sfuphantom/vcu-hw/PHANTOM_VCU/VCU_BOM_IncludingInventory.xlsx

Comment | Description | Designator | Footprint | Manufacturer Part Number | Quantity | Supplier Part Number 1 | Supplier Subtotal 1 | Inventory in Capstone | Needed (for 10 VCUs), no extras
100nF | CAP MLCC 0.1uF 10V X5R 0402 20% SMD 0402 85C Paper T/R, CAP MLCC 0.1uF 10V X5R 0402 20% SMD 0402 85C Paper T/R, CAP MLCC 0.1uF 10V X5R 0402 20% SMD 0402 85C Paper T/R, CAP MLCC 0.1uF 10V X5R 0402 20% SMD 0402 85C Paper T/R, CAP MLCC 0.1uF 10V X5R 0402 20% SMD 0402 85C Paper T/R, CAP MLCC 0.1uF 10V X5R 0402 20% SMD 0402 85C Paper T/R, CAP MLCC 0.1uF 10V X5R 0402 20% SMD 0402 85C Paper T/R, CAP MLCC 0.1uF 10V X5R 0402 20% SMD 0402 85C Paper T/R, CAP MLCC 0.1uF 10V X5R 0402 20% SMD 0402 85C Paper T/R, CAP MLCC 0.1uF 10V X5R 0402 20% SMD 0402 85C Paper T/R, CAP MLCC 0.1uF 10V X5R 0402 20% SMD 0402 85C Paper T/R, CAP MLCC 0.1uF 10V X5R 0402 20% SMD 0402 85C Paper T/R, CAP MLCC 0.1uF 10V X5R 0402 20% SMD 0402 85C Paper T/R, CAP MLCC 0.1uF 10V X5R 0402 20% SMD 0402 85C Paper T/R, CAP MLCC 0.1uF 10V X5R 0402 20% SMD 0402 85C Paper T/R, CAP MLCC 0.1uF 10V X5R 0402 20% SMD 0402 85C Paper T/R, CAP MLCC 0.1uF 10V X5R 0402 20% SMD 0402 85C Paper T/R, CAP MLCC 0.1uF 10V X5R 0402 20% SMD 0402 85C Paper T/R, CAP MLCC 0.1uF 10V X5R 0402 20% SMD 0402 85C Paper T/R, CAP MLCC 0.1uF 10V X5R 0402 20% SMD 0402 85C Paper T/R, CAP MLCC 0.1uF 10V X5R 0402 20% SMD 0402 85C Paper T/R, CAP MLCC 0.1uF 10V X5R 0402 20% SMD 0402 85C Paper T/R, CAP MLCC 0.1uF 10V X5R 0402 20% SMD 0402 85C Paper T/R, CAP MLCC 0.1uF 10V X5R 0402 20% SMD 0402 85C Paper T/R, CAP MLCC 0.1uF 10V X5R 0402 20% SMD 0402 85C Paper T/R, CAP MLCC 0.1uF 10V X5R 0402 20% SMD 0402 85C Paper T/R, CAP MLCC 0.1uF 10V X5R 0402 20% SMD 0402 8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 | C1, C4, C5, C6, C7, C8, C9, C10, C11, C12, C13, C14, C15, C16, C19, C20, C21, C22, C23, C24, C25, C26, C27, C28, C29, C30, C31, C32, C33, C34, C35, C36, C37, C38, C41, C42, C45, C53 | C0402 | CL05A104MP5NNNC, CL05A104MP5NNNC, CL05A104MP5NNNC, CL05A104MP5NNNC, CL05A104MP5NNNC, CL05A104MP5NNNC, CL05A104MP5NNNC, CL05A104MP5NNNC, CL05A104MP5NNNC, CL05A104MP5NNNC, CL05A104MP5NNNC, CL05A104MP5NNNC, CL05A104MP5NNNC, CL05A104MP5NNNC, CL05A104MP5NNNC, CL05A104MP5NNNC, CL05A104MP5NNNC, CL05A104MP5NNNC, CL05A104MP5NNNC, CL05A104MP5NNNC, CL05A104MP5NNNC, CL05A104MP5NNNC, CL05A104MP5NNNC, CL05A104MP5NNNC, CL05A104MP5NNNC, CL05A104MP5NNNC, CL05A104MP5NNNC, CL05A104MP5NNNC, CL05A104MP5NNNC, CL05A104MP5NNNC, CL05A104MP5NNNC, CL05A104MP5NNNC, CL05A104MP5NNNC, CL05A104MP5NNNC, CL05A104MP5NNNC, CL05A104MP5NNNC, CC0402ZRY5V8BB104, CC0402ZRY5V8BB104 | 38 | 1276-1443-1-ND |  | 185 | 295
100nF 25V | CAP MLCC 0.1uF 25V | C53, C45 |  |  | 2 | 311-1375-1-ND |  | 17 | 3
1uF | CAP MLCC 1uF 10V 0402 X5R 20% SMD 0402 85C Paper T/R | C2, C3, C17, C18, C48, C56 | C0402 | CL05A105MP5NNNC | 6 | 1276-1448-1-ND (https://octopart-clicks.com/click/altium?sku=1276-1448-1-ND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) | 0.6 | 90 | 0
33pF | CAP MLCC 33pF 10V C0G, NP0 0402 (1005 Metric) 0.039" L x 0.020" W (1.00mm x 0.50mm) | C39, C40 | C0402 | 885012005010 | 2 | 732-7428-1-ND (https://octopart-clicks.com/click/altium?sku=732-7428-1-ND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) | 0.2 | 13 | 7
10uF | CAP MLCC 10uF 25V X5R 0805 | C43, C44, C51, C52 | R0805-3D | TMK212BBJ106KG-T | 4 | 587-2985-1-ND (https://octopart-clicks.com/click/altium?sku=587-2985-1-ND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) | 1 | 19 | 21
22uF | CAP MLCC 22uF 10V 0805 X5R 20% SMD 0805 85C Embossed T/R | C46, C47, C54, C55 | R0805-3D | GRM21BR61A226ME51L | 4 | 490-10511-1-ND (https://octopart-clicks.com/click/altium?sku=490-10511-1-ND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) | 1.4 | 21 | 19
10nF | CAP MLCC 10nF 10V 0402 5R 10% SMD 0402 85C T/R | C49, C57 | C0402 | GRM155R61A103KA01D | 2 | 490-6296-1-ND (https://octopart-clicks.com/click/altium?sku=490-6296-1-ND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) | 0.2 | 13 | 7
10pF | CAP MLCC 10pF 10V 0402 C0G, NP0 0402 (1005 Metric) 0.039" L x 0.020" W (1.00mm x 0.50mm) | C50, C58 | C0402 | 885012005007 | 2 | 732-7425-1-ND (https://octopart-clicks.com/click/altium?sku=732-7425-1-ND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) | 0.2 | 13 | 7
10uF | CAP CER 10uF 16V X5R 10% SMD 0805 85C T/R | C60, C61 | C0805 | CL21A106KOQNNNE | 2 | 1276-1096-1-ND (https://octopart-clicks.com/click/altium?sku=1276-1096-1-ND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) | 0.34 | 0 | 20
Green | LED GREEN CLEAR 0603 SMD LED, 0603, B GREEN, 40MCD, 570NM | D1, D2, D3, D18, D19 | LED_0603 | 150060VS75000 | 5 | 732-4980-1-ND (https://octopart-clicks.com/click/altium?sku=732-4980-1-ND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) | 0.7 | 22 | 28
Red | LED RED CLEAR 0603 SMD 625 nm, 2 V, 30 mA, 250 mcd | D4 | LED_0603 | 150060RS75000 | 1 | 732-4978-1-ND (https://octopart-clicks.com/click/altium?sku=732-4978-1-ND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) | 0.14 | 4 | 6
Blue | LED BLUE CLEAR 0603 SMD 3.2V 145MCD, 470NM | D5, D7, D9, D11, D12, D16 | LED_0603 | 150060BS75000 | 6 | 732-4966-1-ND (https://octopart-clicks.com/click/altium?sku=732-4966-1-ND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) | 0.9 | 19 | 31
S3BB-TP | DIODE GEN PURP 100V 3A DO214AA | D6, D8, D10 | DO-214AA_Diode | S3BB-TP | 3 | S3BB-TPMSCT-ND (https://octopart-clicks.com/click/altium?sku=S3BB-TPMSCT-ND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) | 1.62 | 17 | 13
EAST1616RGBB4 | LED TRICOLOR RED GREEN BLUE | D14 | LED_TRICOLOR | EAST1616RGBB4 | 1 | '1080-1552-1-ND |  | 0 | 10
3.3V | DIODE ZENER 3.3V 1.5W SMA | D15 | DIODE_TVS | 1SMA5913BT3G | 1 | SMAJ5.0ALFCT-ND (https://octopart-clicks.com/click/altium?sku=SMAJ5.0ALFCT-ND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) | 0.47 | 4 | 6
6.4V | DIODE TVS_6V4 5VWM 9.2VC SMA | D17 | DIODE_TVS | SMAJ5.0A | 1 | 1SMA5913BT3GOSCT-ND (https://octopart-clicks.com/click/altium?manufacturer=ON%20Semiconductor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) | 0.51 | 5 | 5
23R @ 100 MHz | FERRITE BEAD Ind Chip Bead Multi-Layer 23Ohm 30% 100MHz Ferrite 3.5A 1806 T/R | FB1, FB2 | FB_1806 | FBMJ4516HL230NTV | 2 | 587-3857-1-ND (https://octopart-clicks.com/click/altium?sku=587-3857-1-ND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) | 0.52 | 8 | 12
61300511121 | CONN_HeaderPins5pos WURTH ELEKTRONIK 61300511121 Board-To-Board Connector, Vertical, WR-PHD Series, Through Hole, Header, 5 Contacts, 2.54 mm | J1 | 5PIN_HEADER | 61300511121 | 1 | 732-5318-ND (https://octopart-clicks.com/click/altium?sku=732-5318-ND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) | 0.25 | 0 | 10
61300411121 | CONN_HeaderPins4pos WURTH ELEKTRONIK 61300411121 Board-To-Board Connector, Vertical, WR-PHD Series, Through Hole, Header, 4 Contacts, 2.54 mm | J2 | 4PIN_HEADER | 61300411121 | 1 | 732-5317-ND (https://octopart-clicks.com/click/altium?sku=732-5317-ND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) | 0.18 | 0 | 10
952-2262-ND | CONN_HeaderPins2pos Headers & Wire Housings 02 SIL VERTICAL PIN HEADER TIN | JP1, JP2, JP4 | 2PIN_HEADER | M20-9990246 | 3 | 952-2262-ND (https://octopart-clicks.com/click/altium?sku=952-2262-ND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) | 0.33 | 0 | 30
732-5316-ND | CONN_HeaderPins3pos WURTH ELEKTRONIK Board-To-Board Connector, Vertical, WR-PHD Series, Through Hole, Header, 3 Contacts, 2.54 mm | JP3, JP5, JP6 | 3PIN_HEADER | 61300311121 | 3 | 732-5316-ND (https://octopart-clicks.com/click/altium?sku=732-5316-ND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) | 0.39 | 0 | 30
2.2uH | IND 2.2uH 6.3A 19.2mOhm 30% 100KHz Ferrite T/R | L1 | IND-6mm | 1255AY-2R2N=P3 | 1 | 490-10807-1-ND (https://octopart-clicks.com/click/altium?sku=490-10807-1-ND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) | 0.48 | 5 | 5
3.3uH | IND 3.3µH 6.5A 25.2 mOhm Max Nonstandard | L2 | IND-6mm | 1264EY-3R3N=P3 | 1 | 490-10821-1-ND (https://octopart-clicks.com/click/altium?sku=490-10821-1-ND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) | 0.51 | 5 | 5
PSMN022-30BL,118 | MOSFET N-CH 30V 30A 22.6mOhm Rds(ON) | Q1 | D2PAK_FETs | PSMN022-30BL,118 | 1 | 1727-7117-1-ND (https://octopart-clicks.com/click/altium?manufacturer=NXP%20Semiconductors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) | 0.84 | 0 | 10
NCV8406ASTT1G | MOSFET Self-Protected Low Side Driver Automotive 4-Pin(3+Tab) SOT-223 T/R | Q4, Q5, Q6 | SOT-223_NFET | NCV8406ASTT1G | 3 | NCV8406ASTT1GOSDKR-ND (https://octopart-clicks.com/click/altium?manufacturer=ON%20Semiconductor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) | 4.08 | 12 | 18
2k2 | RES SMD 2.2K OHM 5% 1/16W 0402 | R1, R6, R7, R15, R16, R17, R23, R24, R25, R26, R37, R38 | R0402 | RC0402JR-072K2L | 12 | 311-2.2KJRCT-ND (https://octopart-clicks.com/click/altium?sku=311-2.2KJRCT-ND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) | 0.156 | 85 | 35
665R | RES SMD 665 OHM 1% 0402 1/16W | R2 | R0402 | RC0402FR-07665RL | 1 | YAG3208CT-ND (https://octopart-clicks.com/click/altium?sku=YAG3208CT-ND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) | 0.1 | 9 | 1
280R | RES SMD 280 OHM 1% 1/16W 0402 | R3, R45, R46 | R0402 | RC0402FR-07280RL | 3 | 311-280LRCT-ND (https://octopart-clicks.com/click/altium?sku=311-280LRCT-ND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) | 0.3 | 9 | 21
10k | RES SMD 10K OHM 5% 1/16W 0402 | R4, R8, R9, R18, R21, R27, R28, R29, R31, R34, R44, R51 | R0402 | RC0402JR-0710KL | 12 | 311-10KJRCT-ND (https://octopart-clicks.com/click/altium?sku=311-10KJRCT-ND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) | 0.156 | 90 | 30
0R001 | Res Thick Film 2512 0.001 Ohm 1% 1W 250ppm/C to 450ppm/C Molded SMD Embossed Carrier T/R | R5 | R2512 | ERJ-M1WTF1M0U | 1 | P1.0NDCT-ND (https://octopart-clicks.com/click/altium?sku=P1.0NDCT-ND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) | 0.57 | 5 | 5
0R | RES SMD 0 OHM 1/16W 0402 | R10, R11, R14, R20, R42, R47, R48 | R0402 | RC0402JR-070RL | 7 | 311-0.0JRCT-ND (https://octopart-clicks.com/click/altium?sku=311-0.0JRCT-ND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) | 0.7 | 36 | 34
120R | RES SMD 120 OHM 5% 0402 1/16W ±100ppm/C Molded SMD Paper T/R | R12 | R0402 | RMCF0402JT120R | 1 | RMCF0402JT120RCT-ND (https://octopart-clicks.com/click/altium?manufacturer=Stackpole%20Electronics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) | 0.1 | 9 | 1
R60 | RES SMD 60.4 OHM 1% 0402 1/16W 100ppm/C Molded SMD SMD Paper T/R | R13 | R0402 | RMCF0402FT60R4 | 1 | RMCF0402FT60R4CT-ND (https://octopart-clicks.com/click/altium?manufacturer=Stackpole%20Electronics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) | 0.1 | 9 | 1
10R | RES SMD 10 OHM 5% 1/16W 0402 | R19, R39, R43 | R0402 | RC0402JR-0710RL | 3 | 311-10JRCT-ND (https://octopart-clicks.com/click/altium?sku=311-10JRCT-ND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) | 0.3 | 17 | 13
1k | RES SMD 1K OHM 0.5% 1/16W 0402 | R22, R49 | R0402 | RR0510P-102-D | 2 | RR05P1.0KDCT-ND (https://octopart-clicks.com/click/altium?sku=RR05P1.0KDCT-ND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) | 0.2 | 0 | 20
60R4 | RES SMD 60.4 OHM 1% 0402 1/16W 100ppm/C Molded SMD SMD Paper T/R | R30, R40, R41 | R0402 | RMCF0402FT60R4 | 3 | RMCF0402FT60R4CT-ND (https://octopart-clicks.com/click/altium?manufacturer=Stackpole%20Electronics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) | 0.3 | 7 | 23
73.2k | RES SMD 73.2K Ohm 0402 1% 0.063W(1/16W) ±100ppm/C Molded SMD Automotive T/R | R32 | R0402 | RMCF0402FT73K2 | 1 | RMCF0402FT73K2CT-ND (https://octopart-clicks.com/click/altium?manufacturer=Stackpole%20Electronics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) | 0.1 | 9 | 1
22.1k | RES SMD 22.1K 0402 Ohm 1% 1/16W ±100ppm/C Molded SMD SMD Paper T/R | R33, R36 | R0402 | RMCF0402FT22K1 | 2 | RMCF0402FT22K1CT-ND (https://octopart-clicks.com/click/altium?manufacturer=Stackpole%20Electronics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) | 0.2 | 13 | 7
124k | RES SMD 124K 0402 1% 1/16W 100ppm/C Molded SMD Paper T/R | R35 | R0402 | RMCF0402FT124K | 1 | RMCF0402FT124KCT-ND (https://octopart-clicks.com/click/altium?manufacturer=Stackpole%20Electronics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) | 0.1 | 9 | 1
2k | RES SMD 2K OHM 1% 1/16W 0402 | R50 | R0402 | RC0402FR-072KL | 1 | 311-2KLRCT-ND (https://octopart-clicks.com/click/altium?sku=311-2KLRCT-ND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) | 0.1 | 0 | 10
33R | RES SMD 33 OHM 5% 0.4W 0805 | R52 | R0805-3D | ESR10EZPJ330 | 1 | RHM33KCT-ND (https://octopart-clicks.com/click/altium?sku=RHM33KCT-ND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) | 0.1 | 0 | 10
PTS645SM43SMTR92LFS | SWITCH TACTILE SPST-NO 0.05A 12V | S1, S2 | PUSH_BUTTON | PTS645SM43SMTR92LFS | 2 | CKN9112CT-ND (https://octopart-clicks.com/click/altium?sku=CKN9112CT-ND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) | 0.32 | 8 | 12
5015 | TEST POINT, PCB, SMT | TP1, TP2, TP3, TP4, TP5, TP6, TP14, TP15 | TP_HOOK | 5015 | 8 | 36-5015CT-ND (https://octopart-clicks.com/click/altium?sku=36-5015CT-ND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) | 3.76 | 30 | 50
INA226AIDGSR | IC MONITOR PWR/CURR BIDIR 10MSOP | U1 | 10-VSSOP_INA226 | INA226AIDGSR | 1 | 296-29034-1-ND (https://octopart-clicks.com/click/altium?sku=296-29034-1-ND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) | 2.88 | 4 | 6
AP65550FN-7 | IC BUCK SYNC 5A, 18V VIN MAX 650kHz COT Step-Down Conv | U2, U3 | DFN-10 | AP65550FN-7 | 2 | AP65550FN-7DICT-ND (https://octopart-clicks.com/click/altium?sku=AP65550FN-7DICT-ND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) | 1.54 | 13 | 7
MIC5504-1.2YM5-TR | IC LDO 1.2V 300mA Enable Pull-Down & Auto Discharge, 5 SOT-23 T/R | U4 | SOT23-5-MIC5504 | MIC5504-1.2YM5-TR | 1 | 576-4878-1-ND (https://octopart-clicks.com/click/altium?sku=576-4878-1-ND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) | 0.11 | 14 | 0
TMS5701227CPGEQQ1 | IC MCU 16-Bit/32-Bit Hercules TMS570 ARM Cortex R4F RISC 1280KB Flash 1.2V/3.3V 144-Pin LQFP | U5 | LQFP-144 | TMS5701227CPGEQQ1 | 1 | 296-42451-ND (https://octopart-clicks.com/click/altium?sku=296-42451-ND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) | 24.99 | 11 | 0
TPS2115ADRBR | IC OR CTRLR SRC SELECT 8SON | U6 | VSON-8 | TPS2115ADRBR | 1 | 296-23394-1-ND (https://octopart-clicks.com/click/altium?sku=296-23394-1-ND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) | 2.01 | 5 | 5
MCP2561FD-E/SN | IC CAN Bus, Transceiver, CAN, 1, 1, 4.5 V, 5.5 V, SOIC | U7 | 8-SOIC_MCP2561 | MCP2561FD-E/SN | 1 | MCP2561FD-E/SN-ND |  | 5 | 5
MCP48FVB01-E/UN | IC DAC 8BIT V-OUT BUFF 10-MSOP | U8 | MSSOP-10 | MCP48FVB01-E/UN | 1 | MCP48FVB01-E/UN-ND (https://octopart-clicks.com/click/altium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) | 0.7 | 0 | 10
FT230XQ-R | IC USB SERIAL BASIC UART 16QFN | U9 | QFN16-EP | FT230XQ-R | 1 | 768-1130-1-ND (https://octopart-clicks.com/click/altium?sku=768-1130-1-ND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) | 2.04 | 4 | 6
STWD100YNYWY3F | IC WATCHDOG TIME CIRCUIT SOT23-5 | U10 | SOT23-5-WATCHDOG | STWD100YNYWY3F | 1 | 497-14411-1-ND (https://octopart-clicks.com/click/altium?sku=497-14411-1-ND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) | 0.94 | 0 | 10
WM10445-ND | CONN_20Positions Molex Stac64 Header, Shrouded Connector 0.100" (2.54mm) Through Hole, Right Angle Tin | X1, X2 | MOLEX_20pin | 0346916200 | 2 | WM10445-ND (https://octopart-clicks.com/click/altium?sku=WM10445-ND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) | 6.44 | 0 | 0
68602-116HLF | CONN_HeaderPins16pos1 6 Positions Header, Unshrouded Connector 0.100" (2.54mm) Through Hole Gold or Gold, GXT™ | X4 | 16PIN_HEADER | 68602-116HLF | 1 | 609-3364-ND (https://octopart-clicks.com/click/altium?manufacturer=AMPHENOL%20ICC%20%28FCI%29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) | 0.79 | 8 | 2
0768250002 | CONN_2Position_MEGAFIT Molex Through Hole, Right Angle Tin | X5 | MOLEX_2PIN_MEGAFIT | 0768250002 | 1 | WM11969-ND (https://octopart-clicks.com/click/altium?sku=WM11969-ND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) | 1.13 | 6 | 4
FTSH-105-01-F-DV-K | CONN_JTAG_10pin .050 Connector Dual Header 10 Position Surface Mount | X6 | JTAG_50mil_10pin | FTSH-105-01-F-DV-K | 1 | SAM8796-ND (https://octopart-clicks.com/click/altium?sku=SAM8796-ND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) | 2.9 | 4 | 6
10118192-0001LF | CONN_USB - micro B USB 2.0 Receptacle Connector 5 Position Surface Mount, Right Angle, Horizontal | X7 | USB_MICRO | 10118192-0001LF | 1 | 609-4613-1-ND (https://octopart-clicks.com/click/altium?manufacturer=AMPHENOL%20ICC%20%28FCI%29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) | 0.42 | 6 | 4
ABLS2-16.000MHZ-D4Y-T | XTAL 16MHz ±30ppm Crystal 18pF 40 Ohm -40°C ~ 85°C Surface Mount HC49/US | XTAL1 | XTAL | ABLS2-16.000MHZ-D4Y-T | 1 | 535-9875-1-ND (https://octopart-clicks.com/click/altium?sku=535-9875-1-ND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) | 0.46 | 6 | 4
12V | DIODE ZENER 12V 5W DO214AA | Z1, Z2, Z3 | DO-214AA_Diode | SMBJ5349B-TP | 3 | SMBJ5349B-TPMSDKR-ND (https://octopart-clicks.com/click/altium?sku=SMBJ5349B-TPMSDKR-ND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) | 2.04 | 12 | 18
mating connectors
mating crimps
