sfuphantom/vcu-hw/PHANTOM_VCU/PHANTOM_VCU_SCHEMATIC.pdf

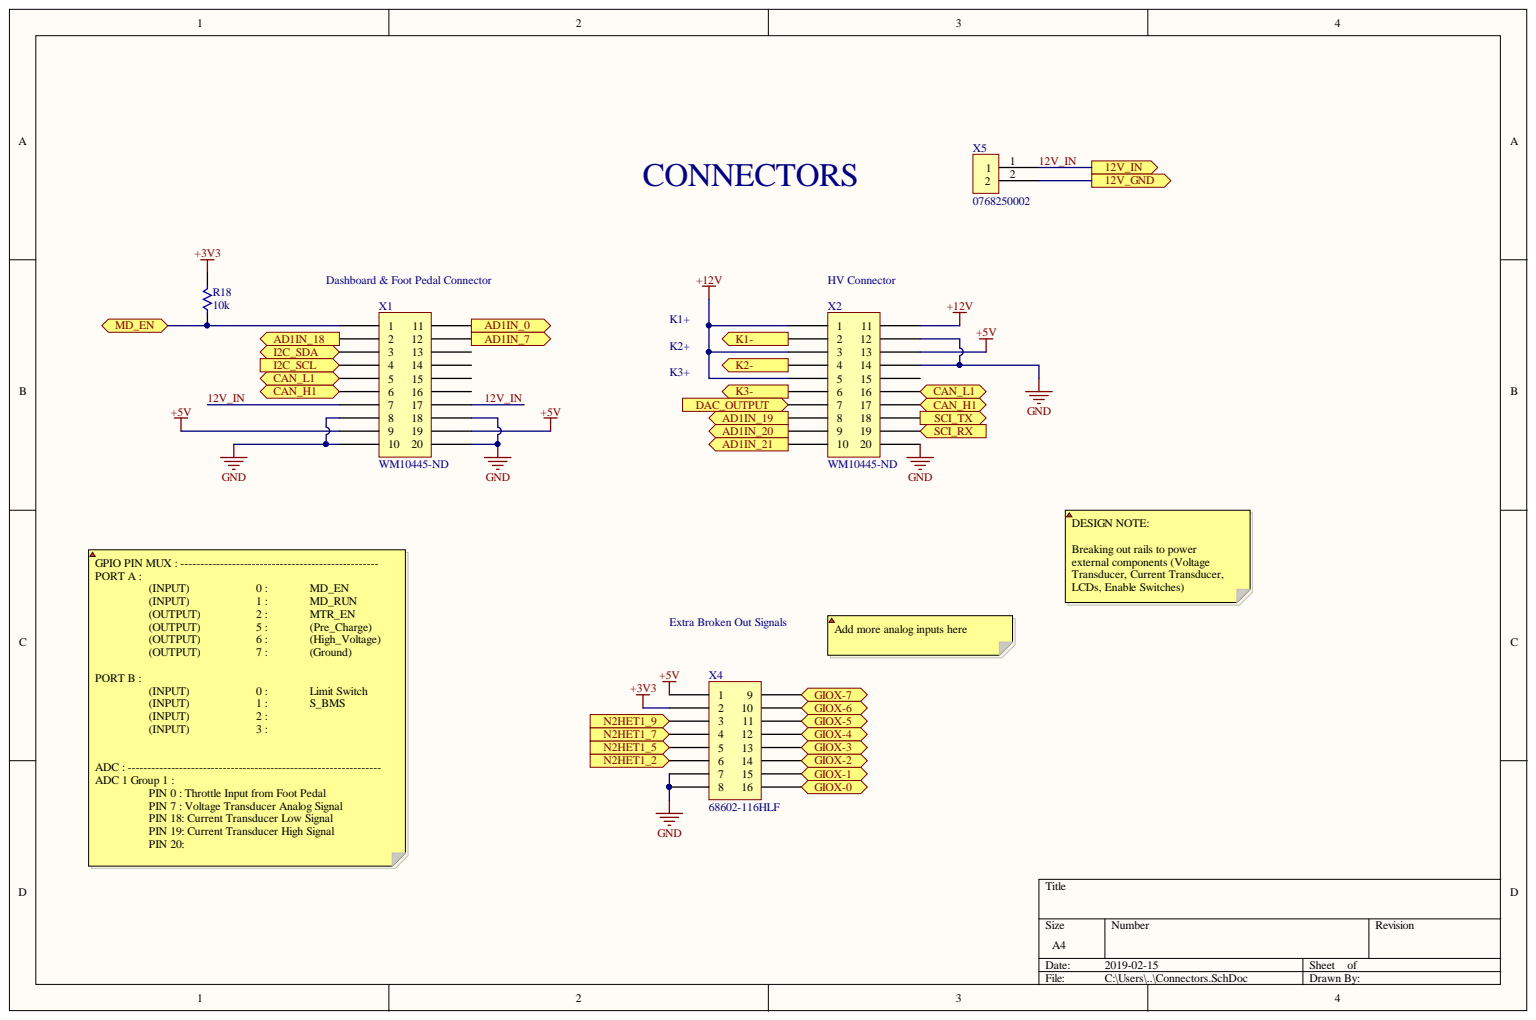
[picture p1: page 1]

Dashboard & Foot Pedal Connector

Breaking out rails to power
external components (Voltage
Transducer, Current Transducer,
LCDs, Enable Switches)

Extra Broken Out Signals

Add more analog inputs here

PIN 0 : Throttle Input from Foot Pedal
PIN 7 : Voltage Transducer Analog Signal
PIN 18: Current Transducer Low Signal
PIN 19: Current Transducer High Signal
PIN 20:

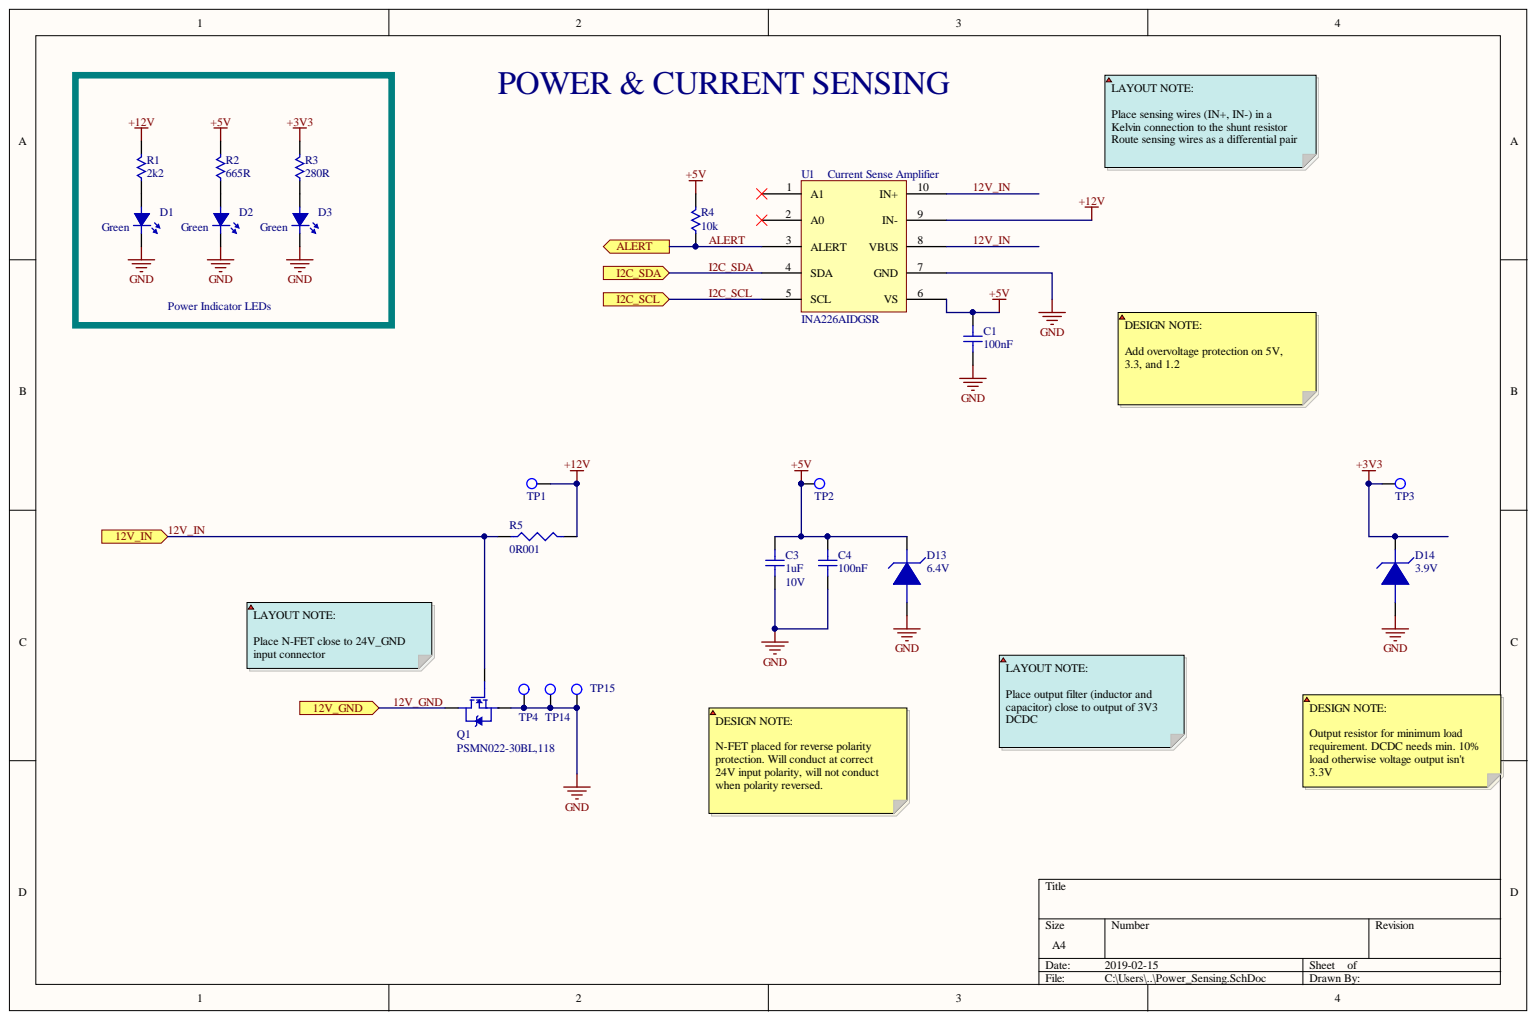
[picture p2: page 2]

Place sensing wires (IN+, IN-) in a
Kelvin connection to the shunt resistor
Route sensing wires as a differential pair

Add overvoltage protection on 5V,
3.3, and 1.2

Place N-FET close to 24V_GND
input connector

Place output filter (inductor and
capacitor) close to output of 3V3

Output resistor for minimum load
requirement. DCDC needs min. 10%
load otherwise voltage output isn't

N-FET placed for reverse polarity
protection. Will conduct at correct
24V input polarity, will not conduct
when polarity reversed.

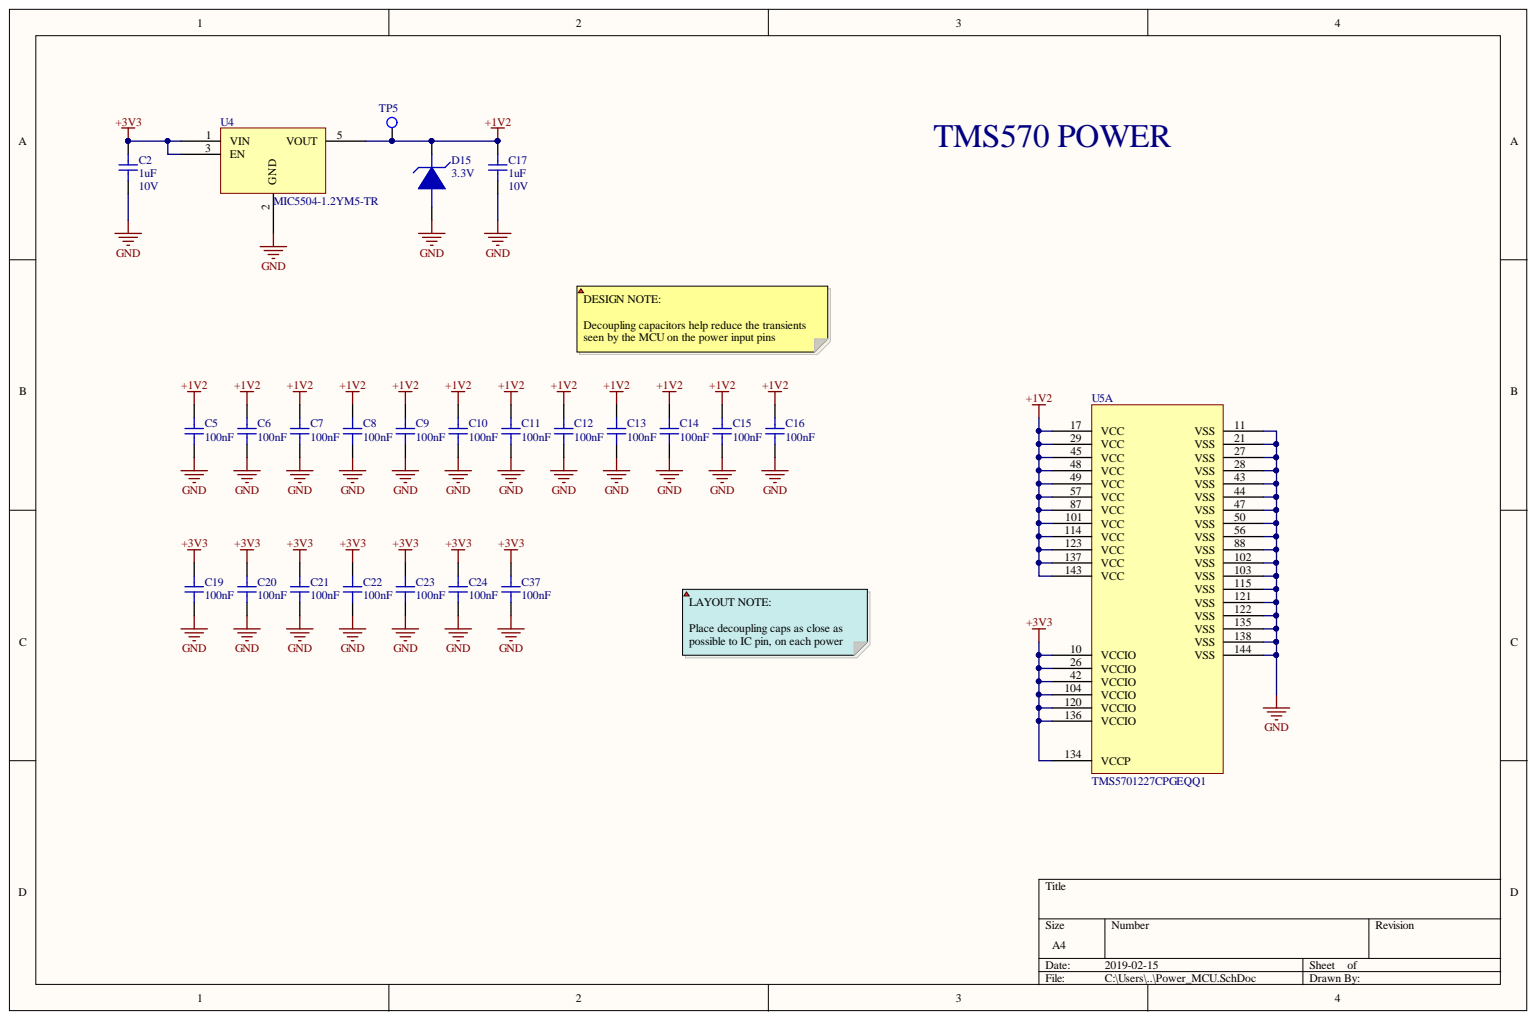
[picture p3: page 3]

Decoupling capacitors help reduce the transients
seen by the MCU on the power input pins

Place decoupling caps as close as
possible to IC pin, on each power

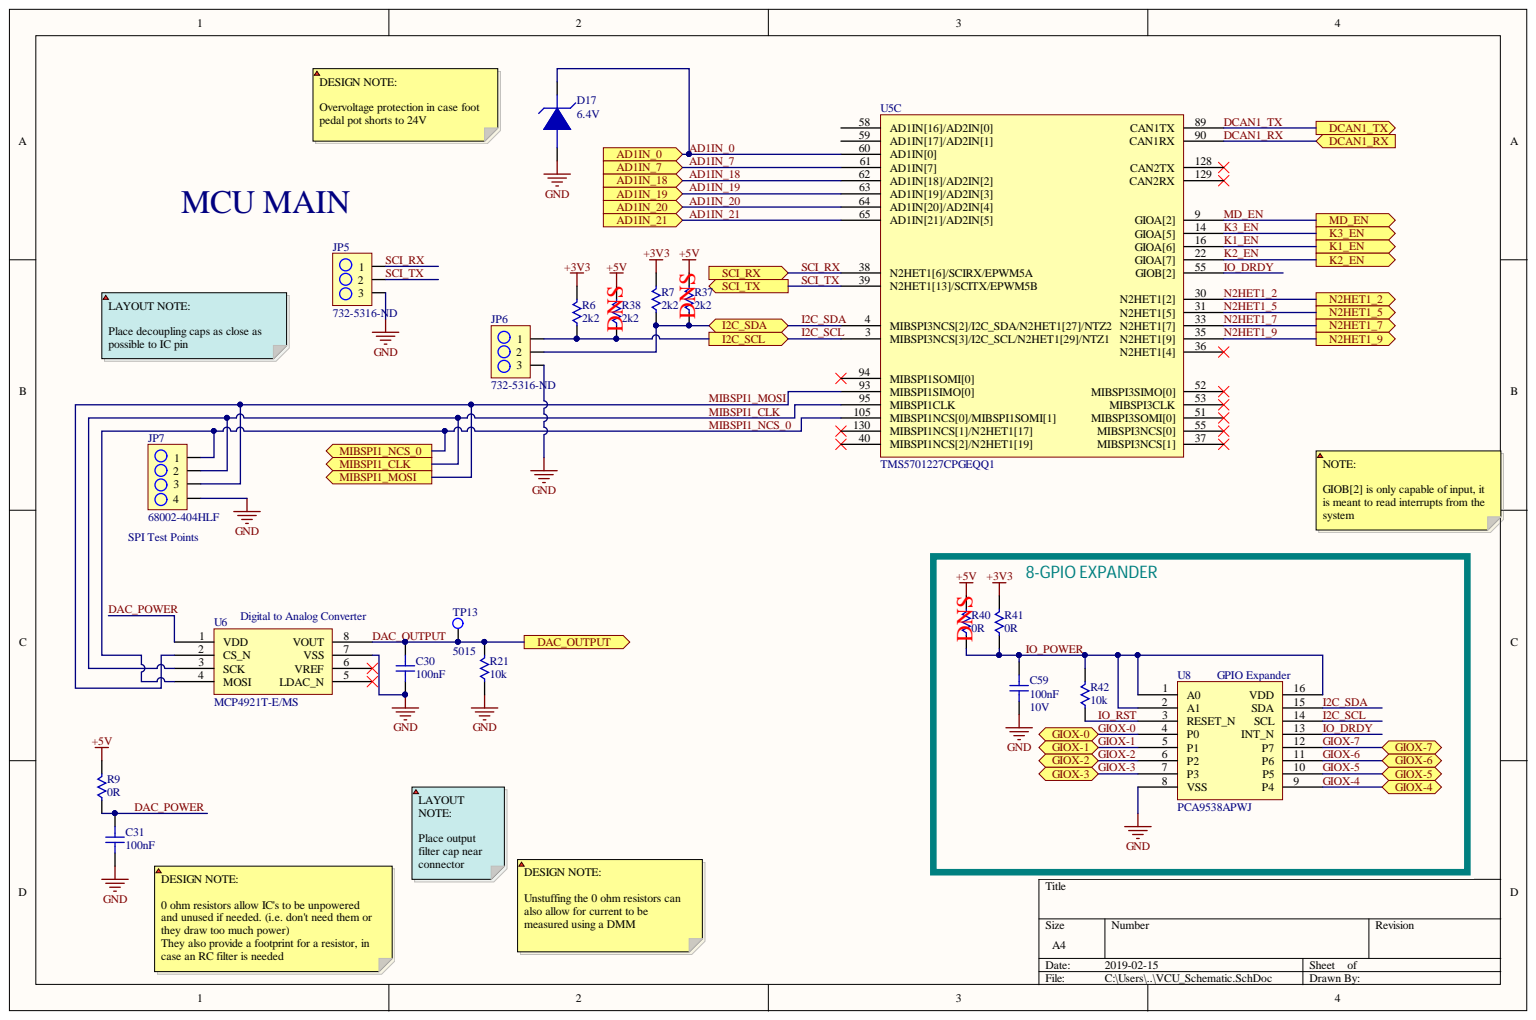
[picture p4: page 4]

Overvoltage protection in case foot
pedal pot shorts to 24V

Place decoupling caps as close as
possible to IC pin

MIBSPI1_CLK | MIBSPI1NCS[0]/MIBSPI1SOMI[1] 105
MIBSPI1_NCS_0 | MIBSPI1NCS[1]/N2HET1[17] 130

JP7 DAC_POWER | | | MIBSPI1NCS[2]/N2HET1[19] 40

GIOB[2] is only capable of input, it
is meant to read interrupts from the
system

+5V +3V3 | R40 0R | 8-GPIO EXPANDER R41 0R

Unstuffing the 0 ohm resistors can
also allow for current to be
measured using a DMM

0 ohm resistors allow IC's to be unpowered
and unused if needed. (i.e. don't need them or
they draw too much power)
They also provide a footprint for a resistor, in
case an RC filter is needed

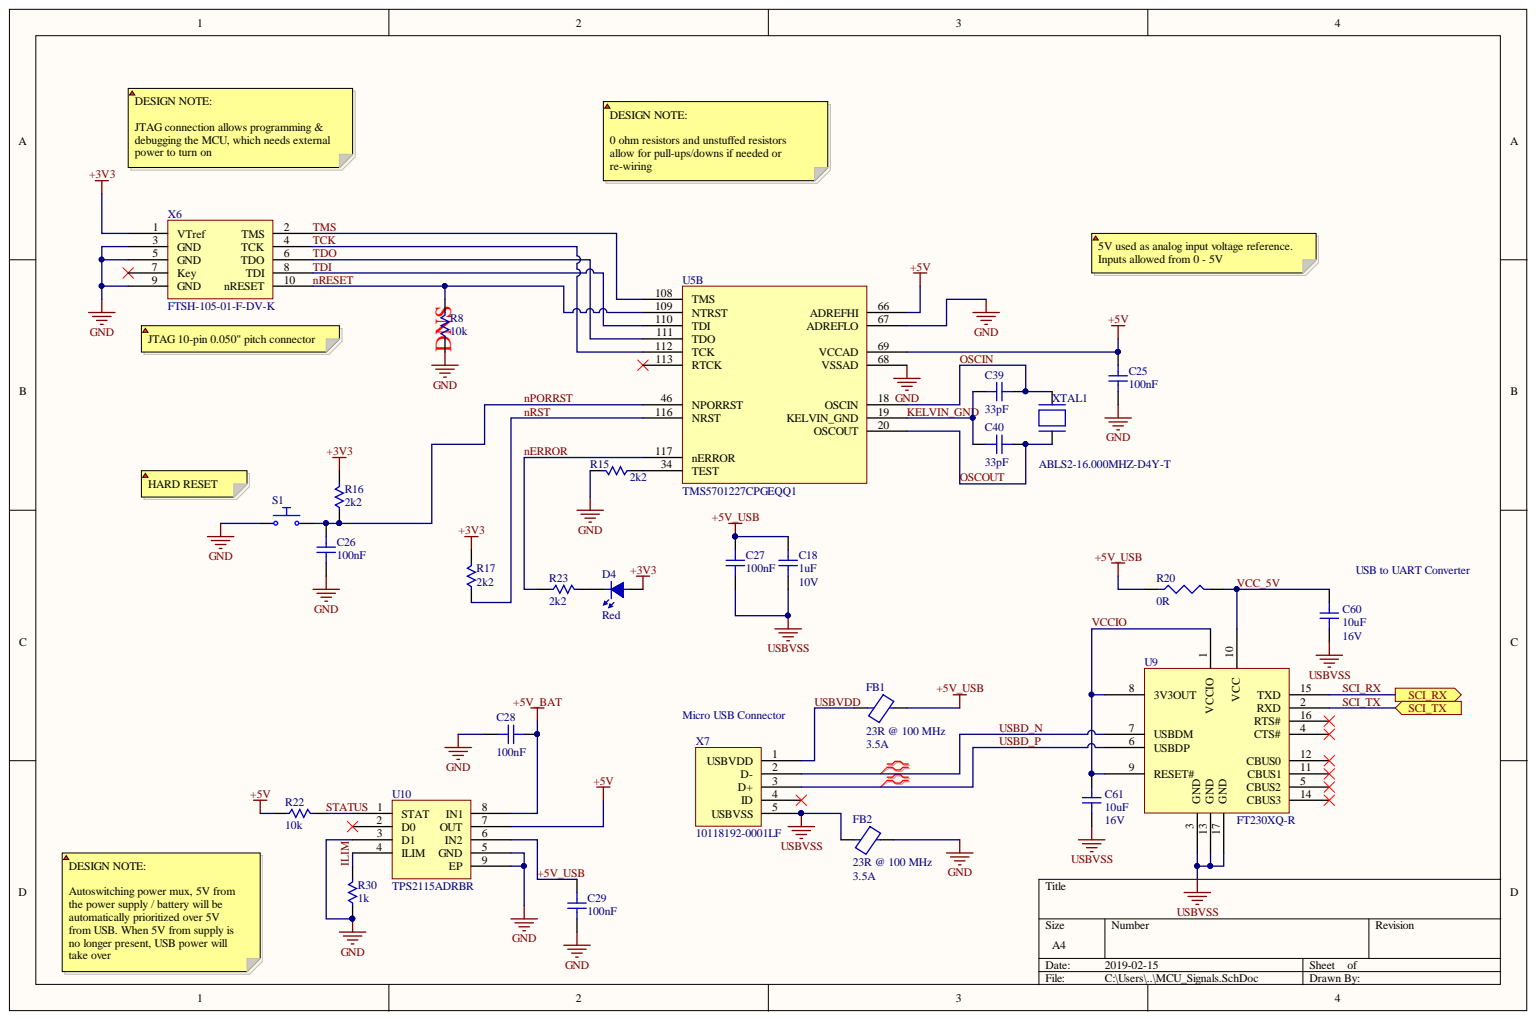
[picture p5: page 5]

JTAG connection allows programming &
debugging the MCU, which needs external
power to turn on

0 ohm resistors and unstuffed resistors
allow for pull-ups/downs if needed or
re-wiring

5V used as analog input voltage reference.
Inputs allowed from 0 - 5V

R8 10k | | TDI 110

JTAG 10-pin 0.050" pitch connector

TCK 112
RTCK 113 | OSCIN

nERROR | | nERROR 117
R15 R23 D4 | | TEST 34

USB to UART Converter

USBDP 6 USBDM 7

USBD_P 3.5A

Autoswitching power mux, 5V from
the power supply / battery will be
automatically prioritized over 5V
from USB. When 5V from supply is
no longer present, USB power will
take over

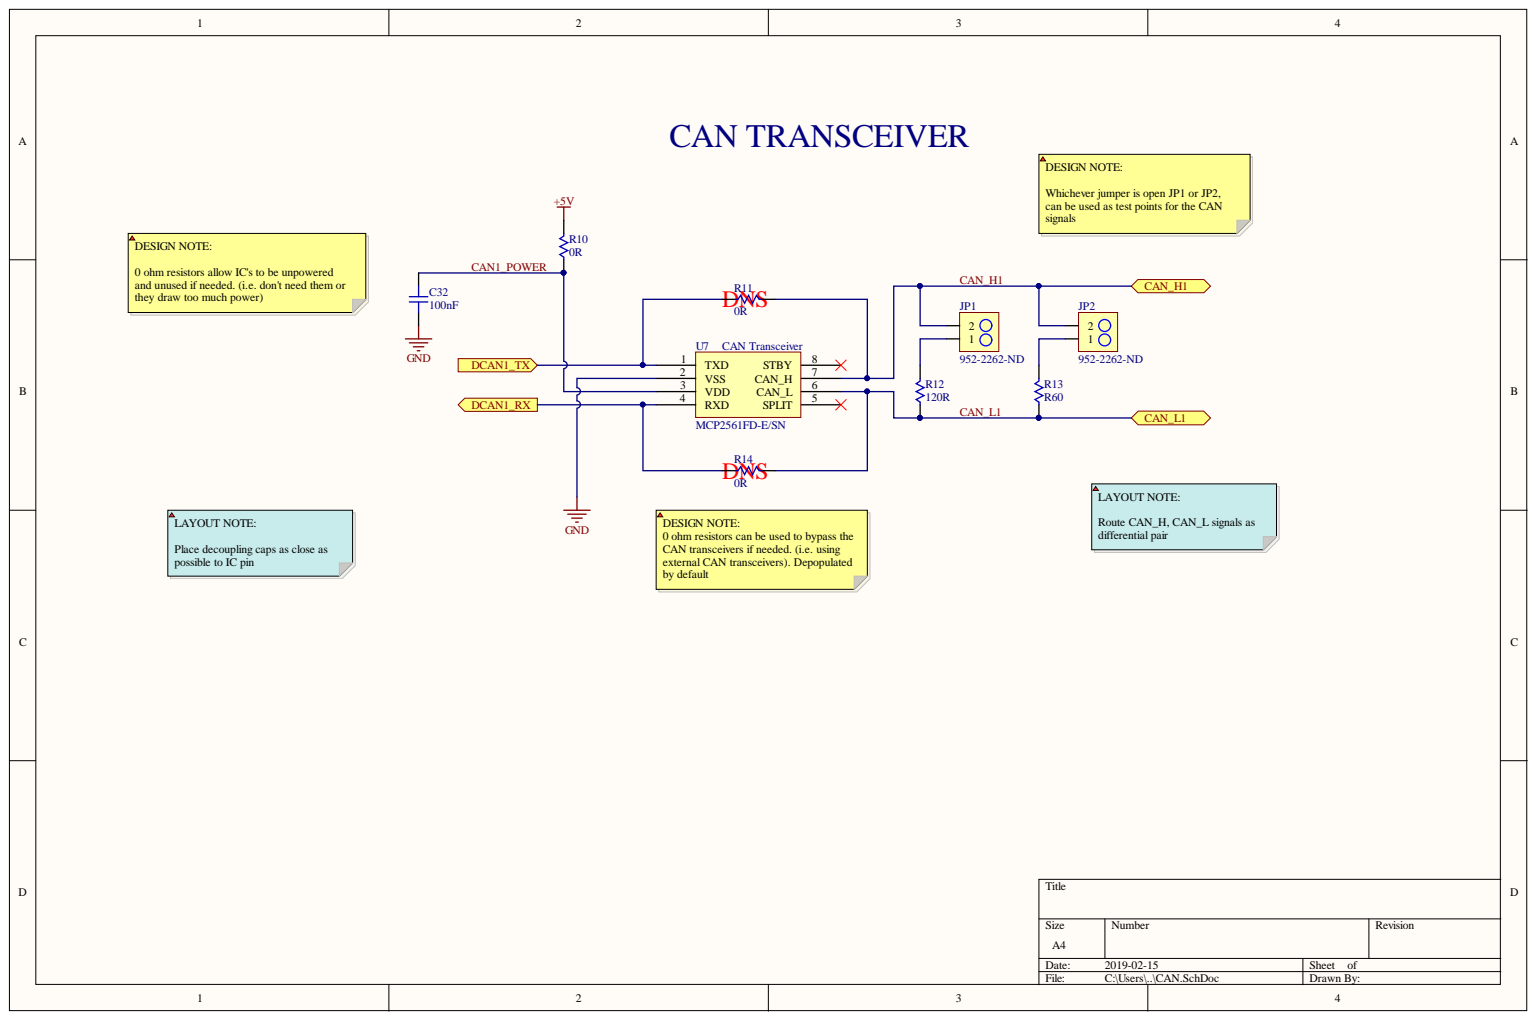
[picture p6: page 6]

LAYOUT NOTE: Place decoupling c

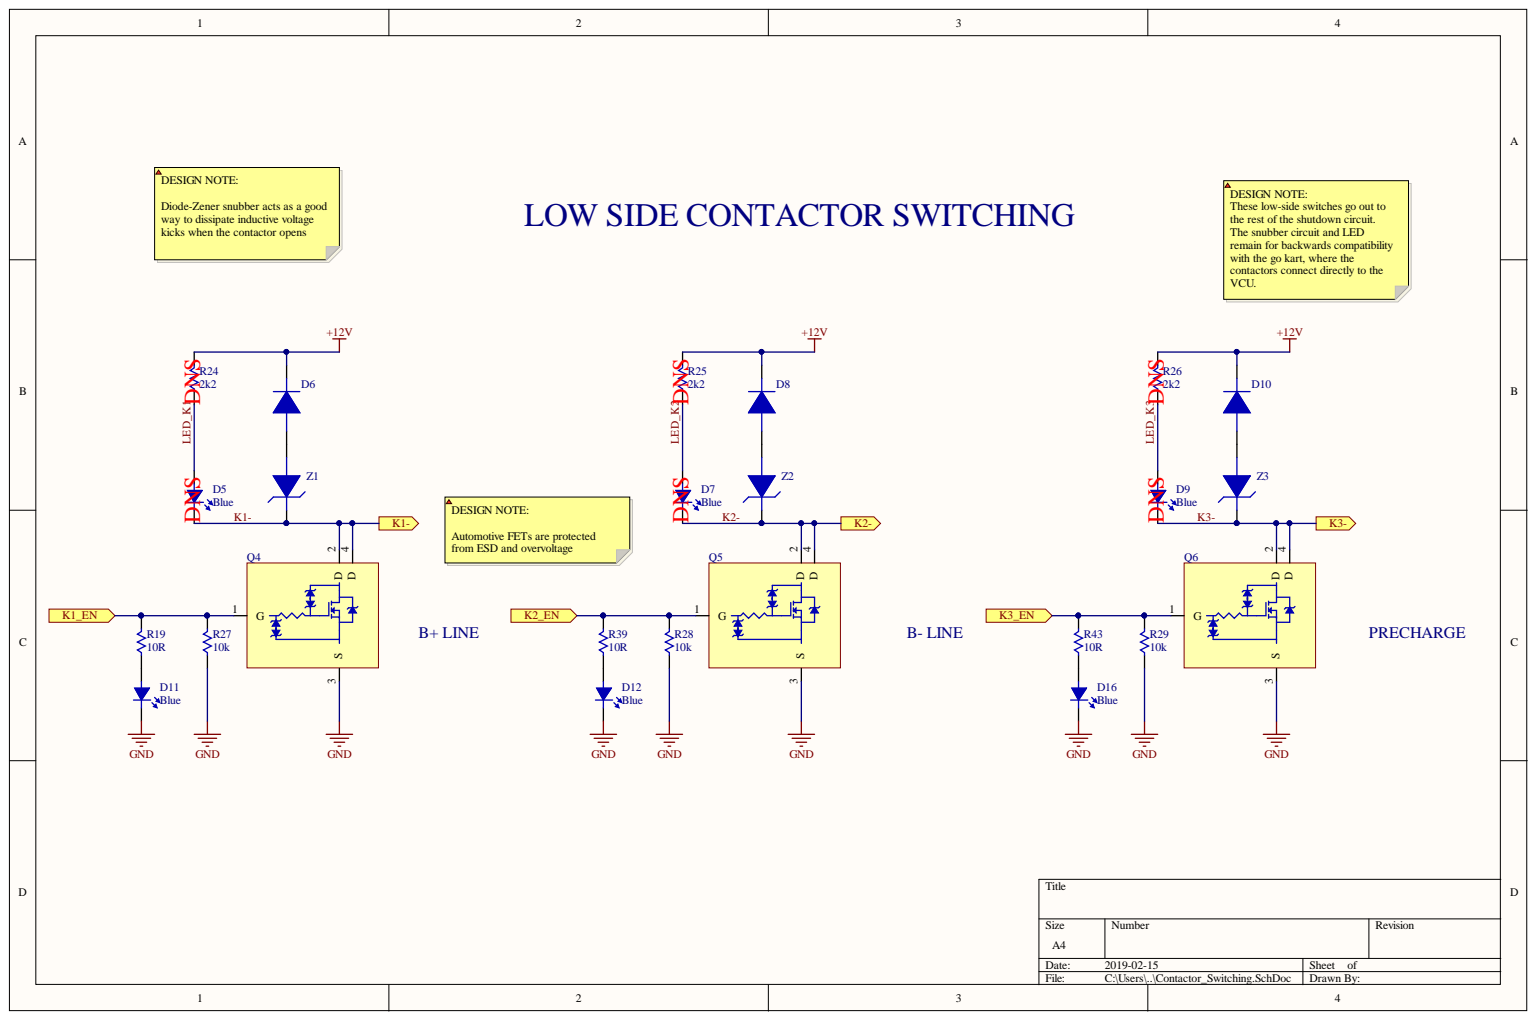
[picture p7: page 7]

DESIGN NOTE:
These low-side switches go out to
the rest of the shutdown circuit.
The snubber circuit and LED
remain for backwards compatibility
with the go kart, where the
contactors connect directly to the
VCU.

Diode-Zener snubber acts as a good
way to dissipate inductive voltage
kicks when the contactor opens

LOW SIDE CONTACTOR SWITCHING

Automotive FETs are protected
from ESD and overvoltage

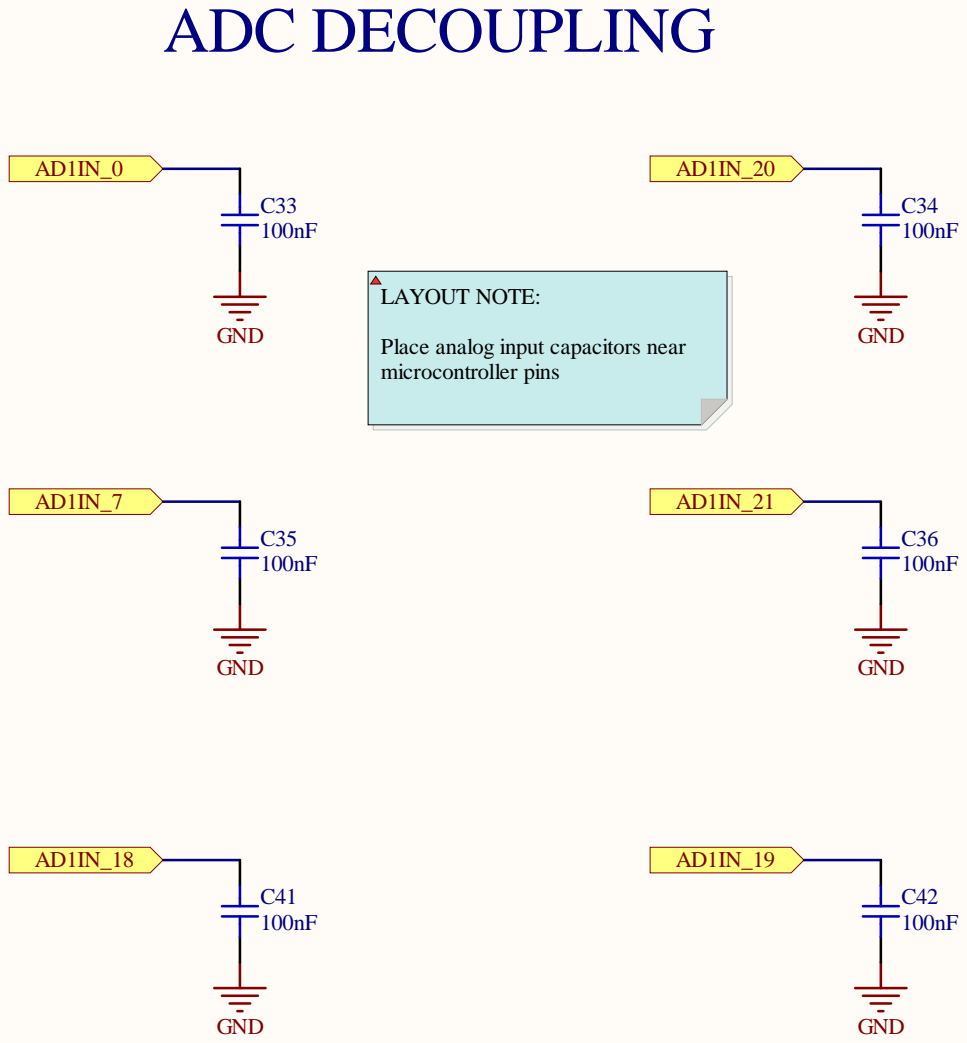
[picture p8: page 8]

Place analog input capacitors near
microcontroller pins

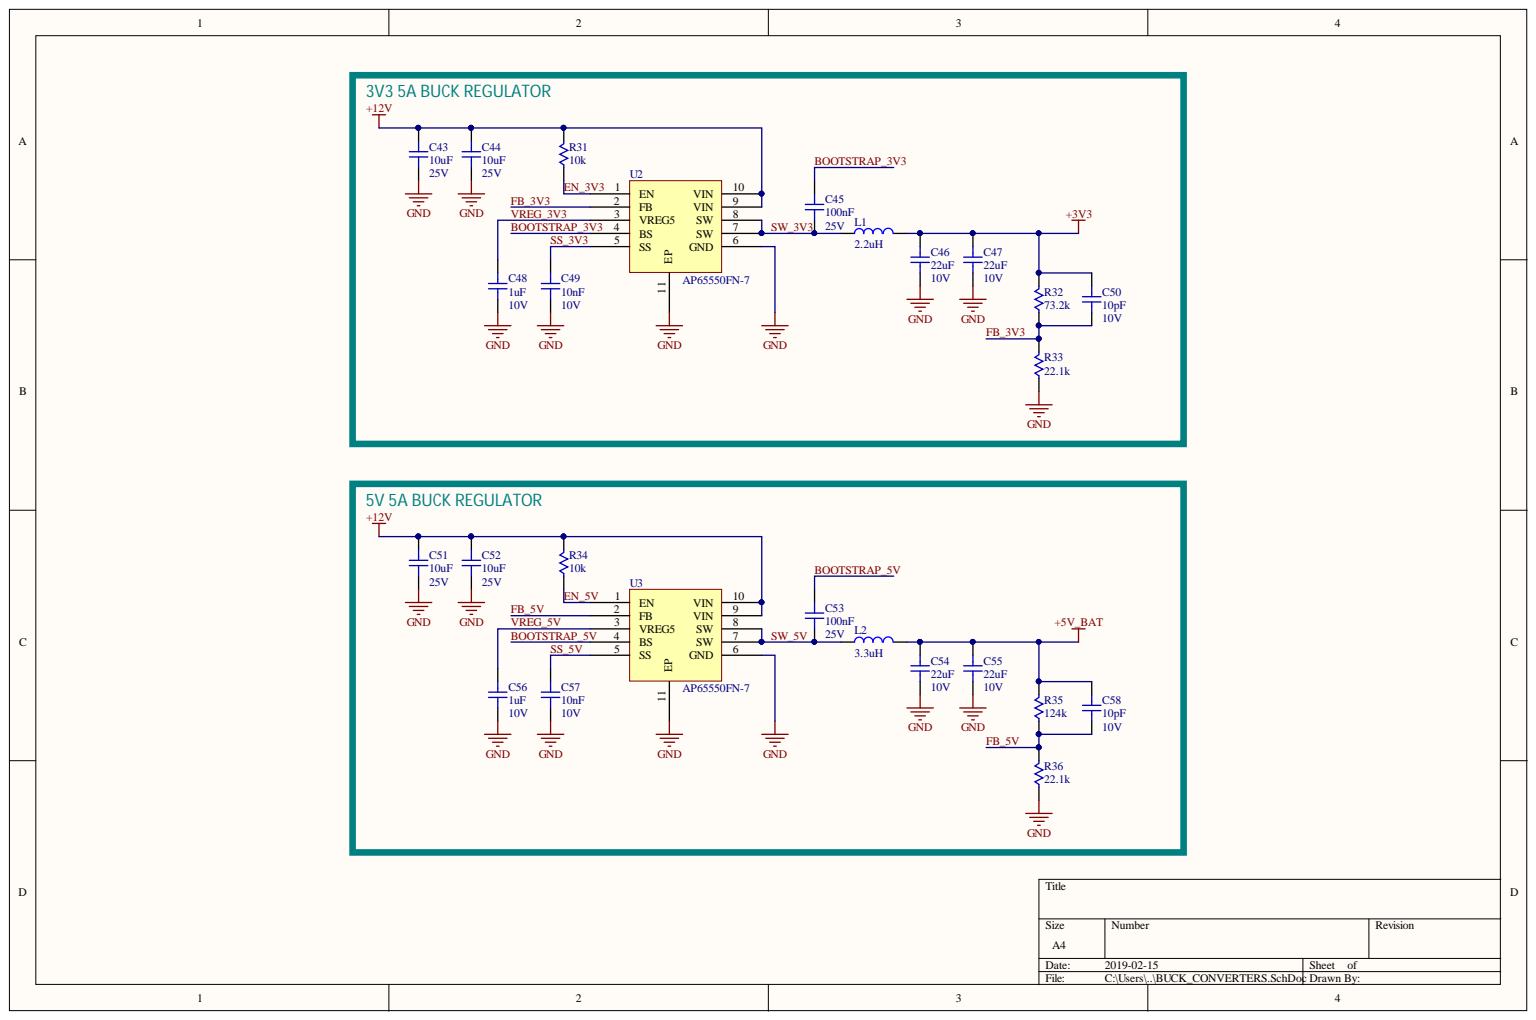
[picture p9: page 9]

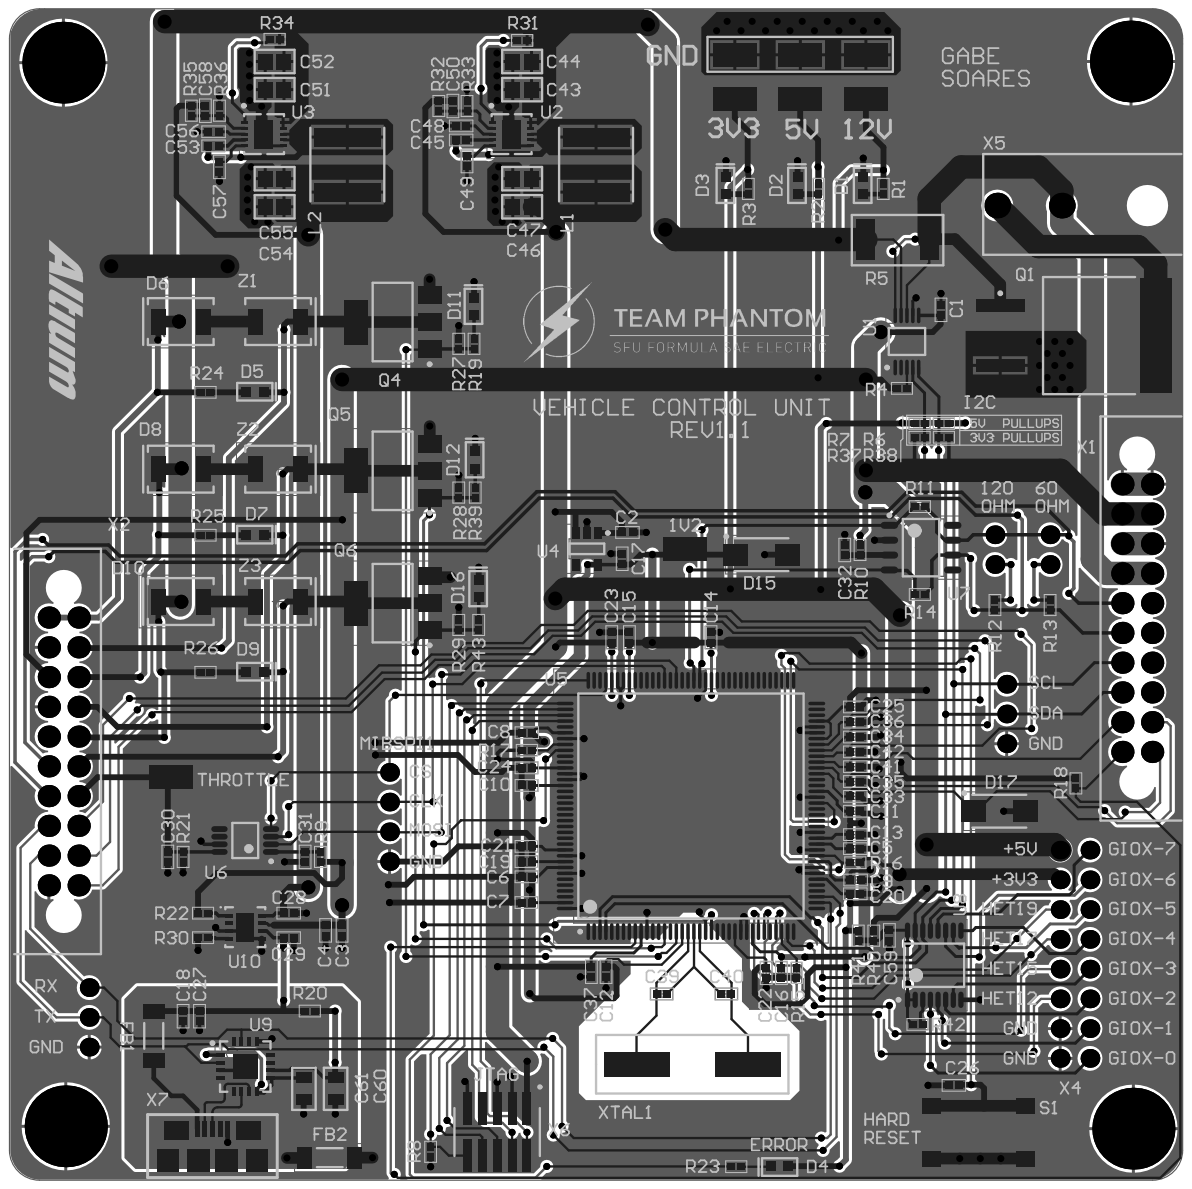
[picture p10: page 10]
