sfuphantom/vcu-hw/PHANTOM_VCU/PHANTOM_VCU_REV3.pdf

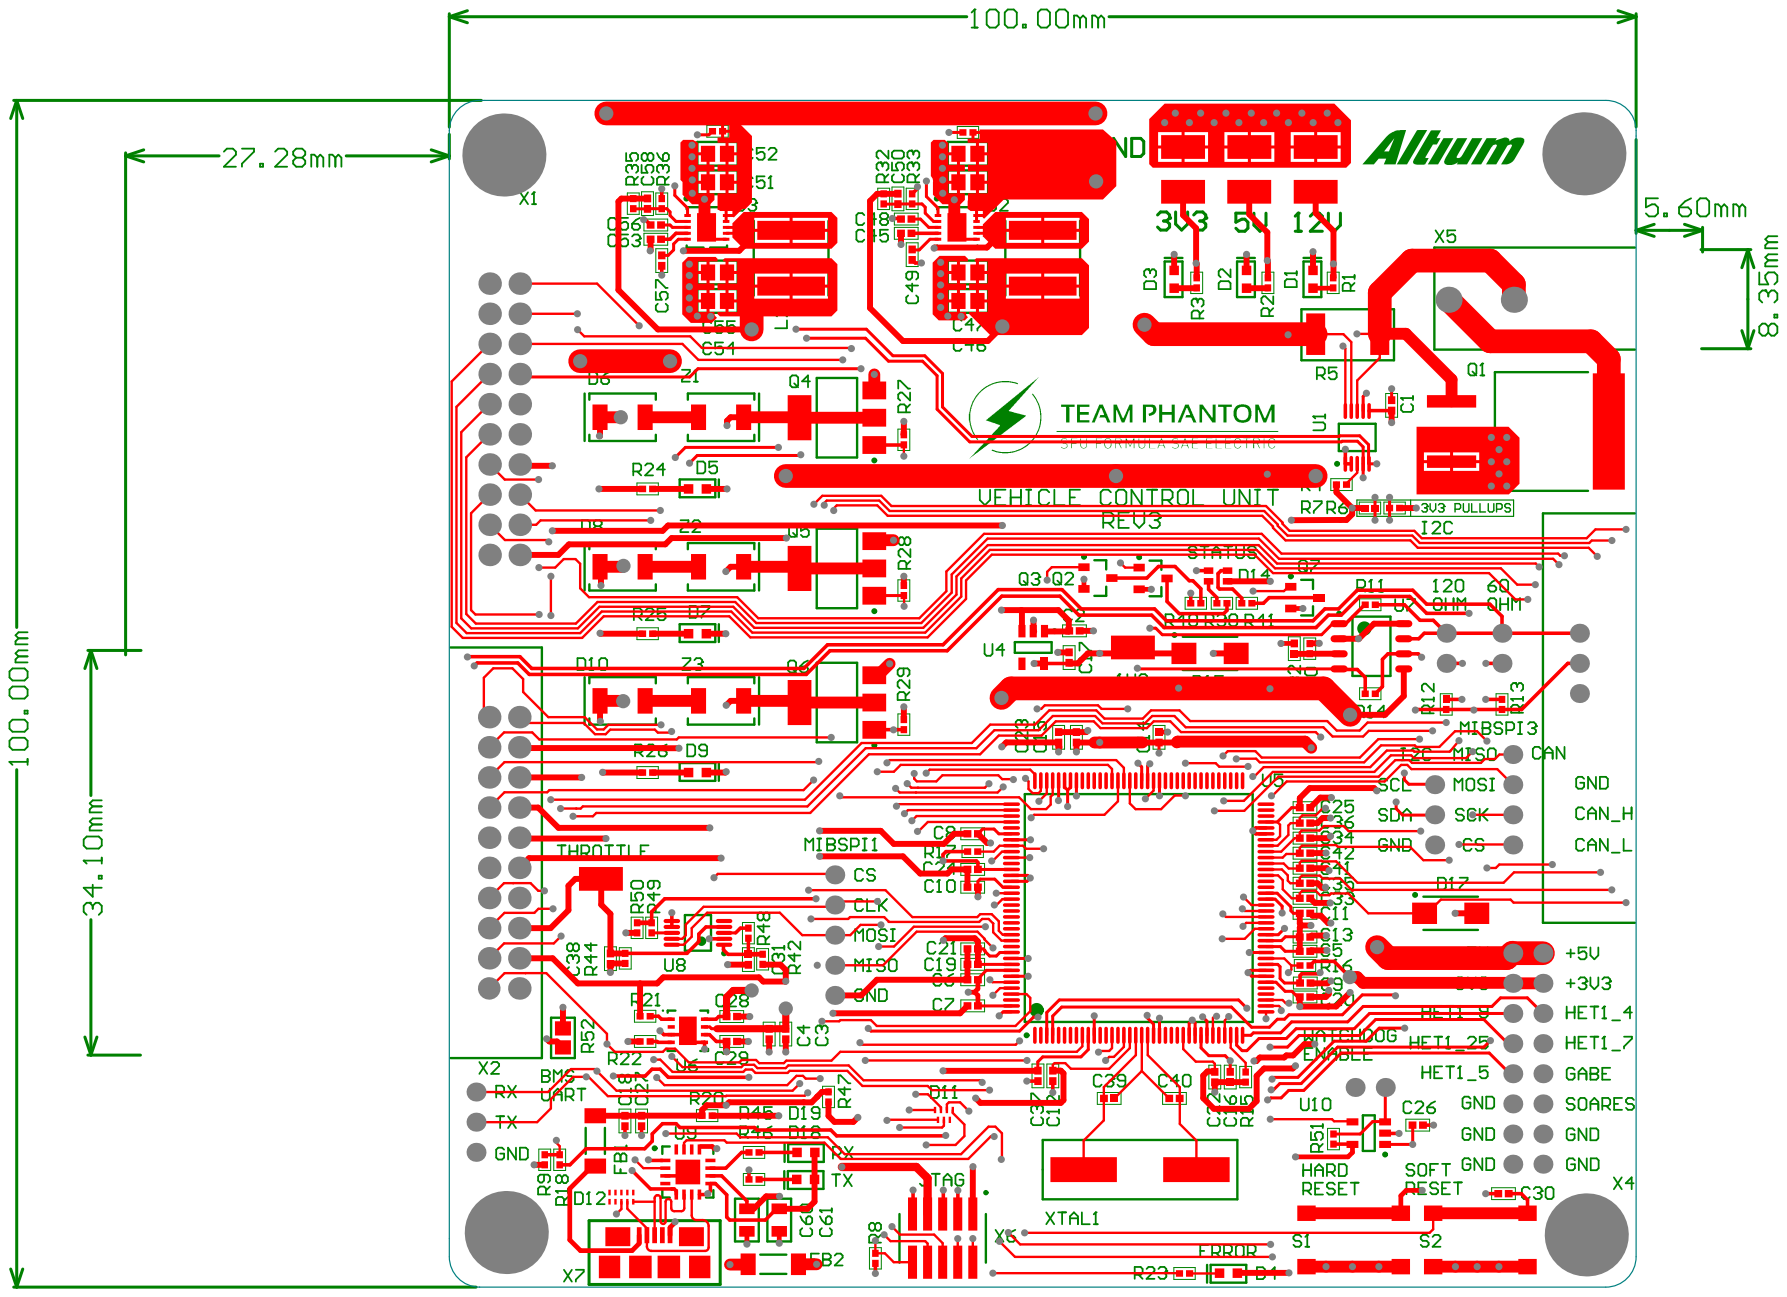
[picture p11: page 1]
