sfuphantom/vcu-hw/PHANTOM_VCU/PHANTOM_VCU.pdf

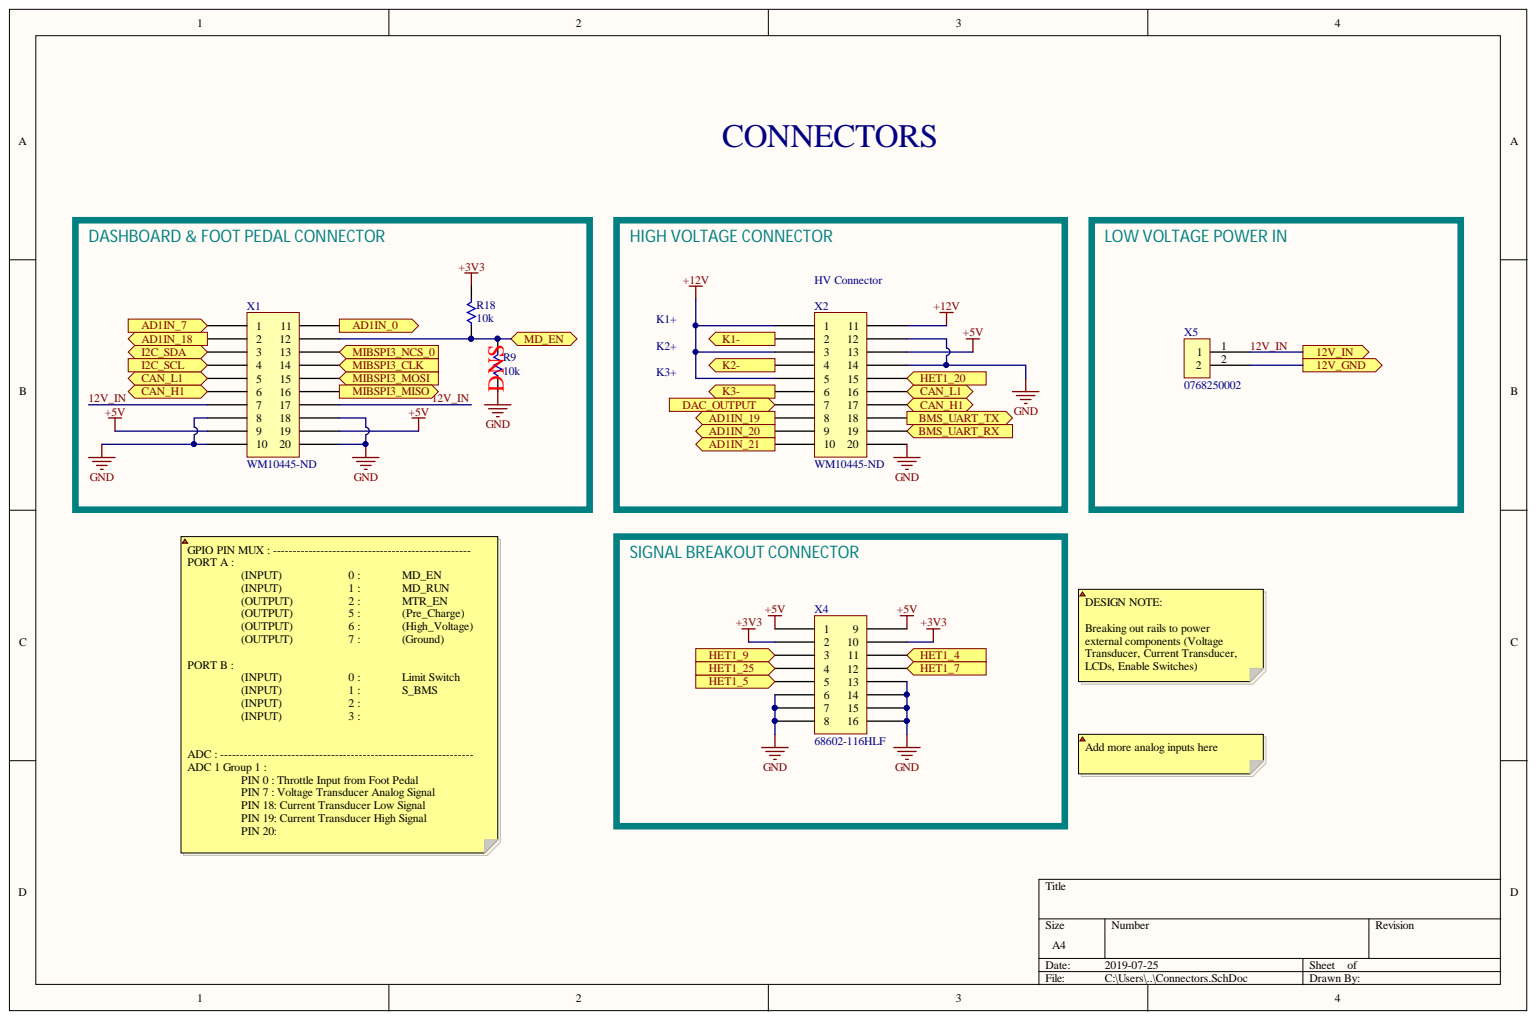
[picture p12: page 1]

LOW VOLTAGE POWER IN

Breaking out rails to power
external components (Voltage
Transducer, Current Transducer,
LCDs, Enable Switches)

Add more analog inputs here

PIN 0 : Throttle Input from Foot Pedal
PIN 7 : Voltage Transducer Analog Signal
PIN 18: Current Transducer Low Signal
PIN 19: Current Transducer High Signal
PIN 20:

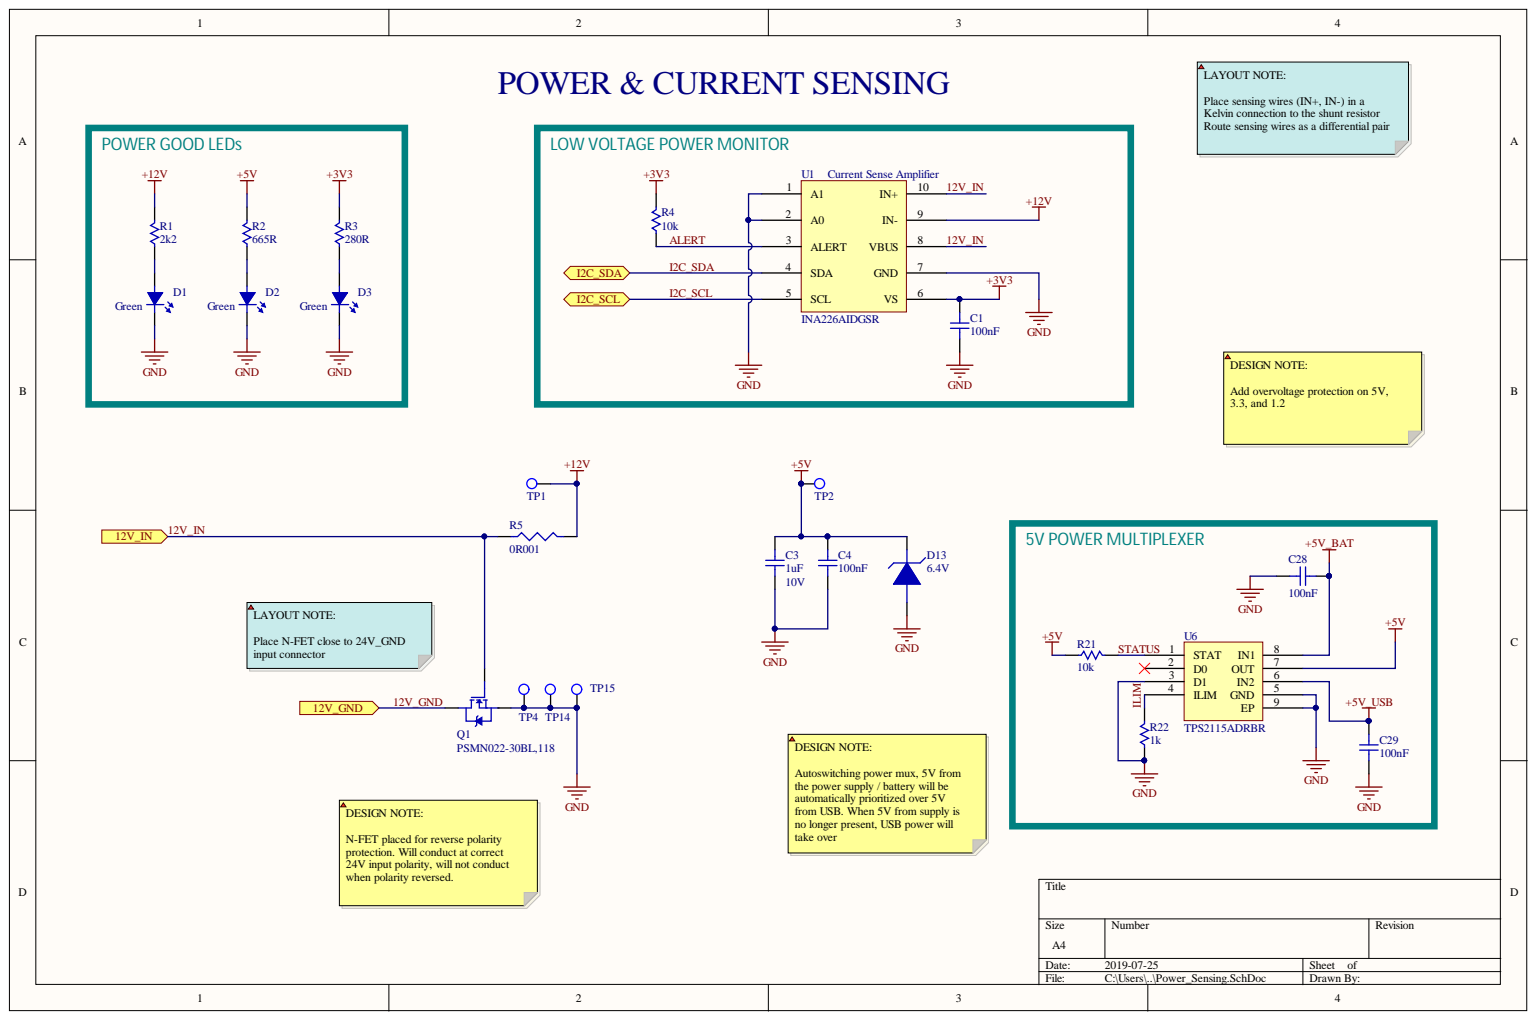
[picture p13: page 2]

Place sensing wires (IN+, IN-) in a
Kelvin connection to the shunt resistor
Route sensing wires as a differential pair

Add overvoltage protection on 5V,
3.3, and 1.2

Place N-FET close to 24V_GND
input connector

Autoswitching power mux, 5V from
the power supply / battery will be
automatically prioritized over 5V
from USB. When 5V from supply is
no longer present, USB power will
take over

N-FET placed for reverse polarity
protection. Will conduct at correct
24V input polarity, will not conduct
when polarity reversed.

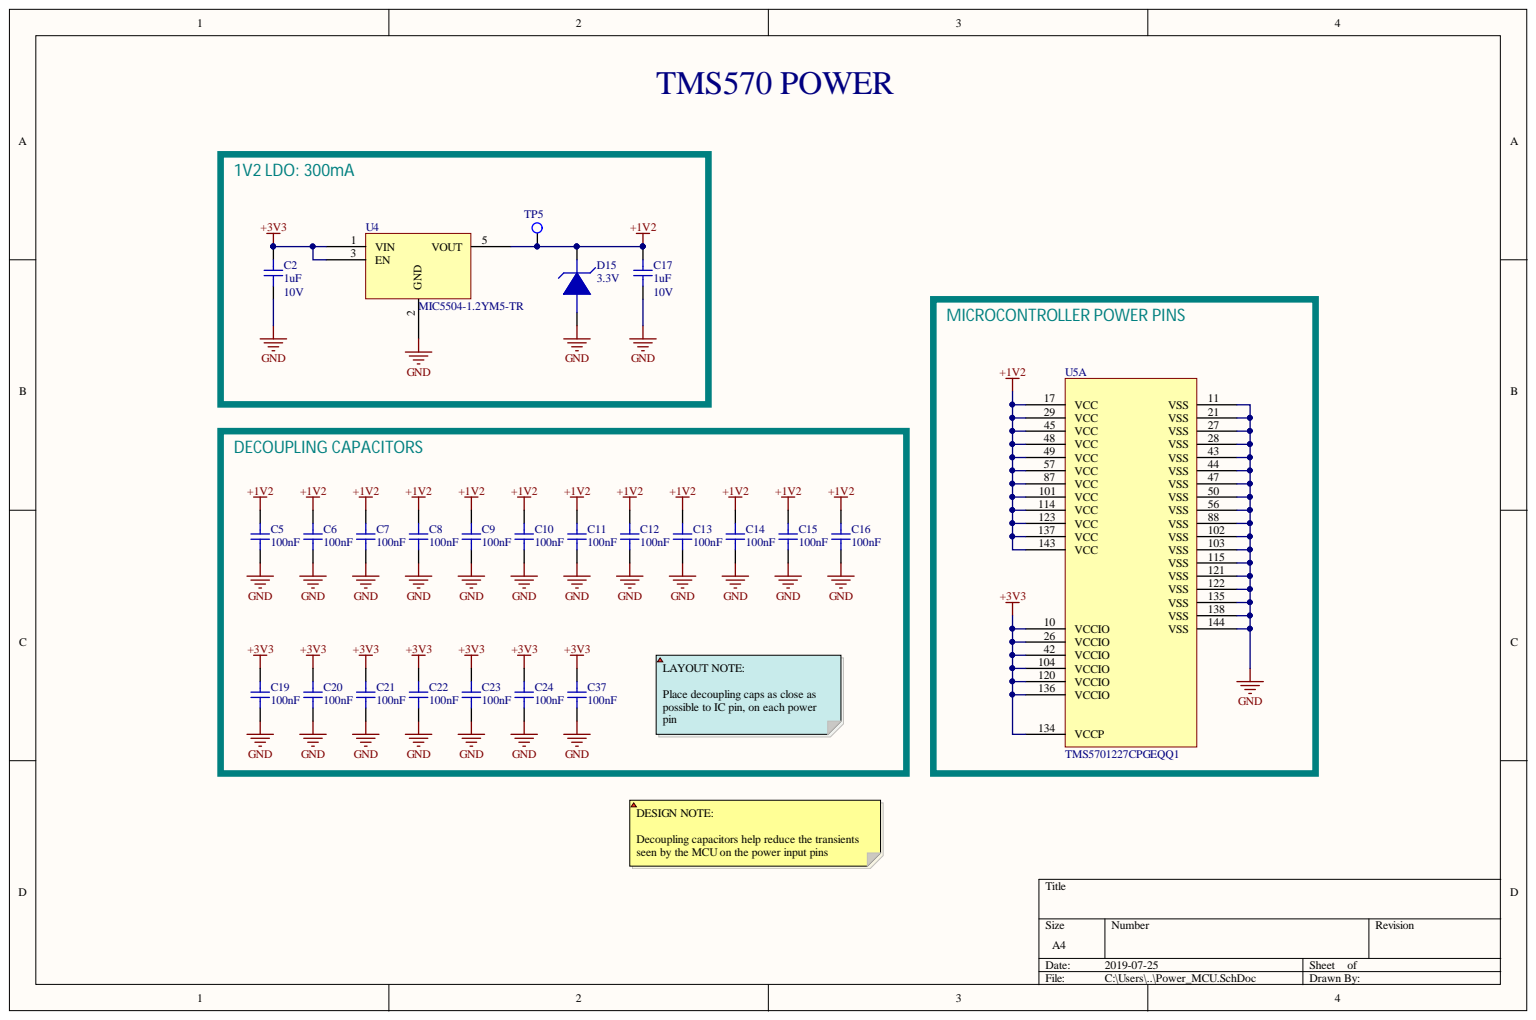
[picture p14: page 3]

Place decoupling caps as close as
possible to IC pin, on each power
pin

Decoupling capacitors help reduce the transients
seen by the MCU on the power input pins

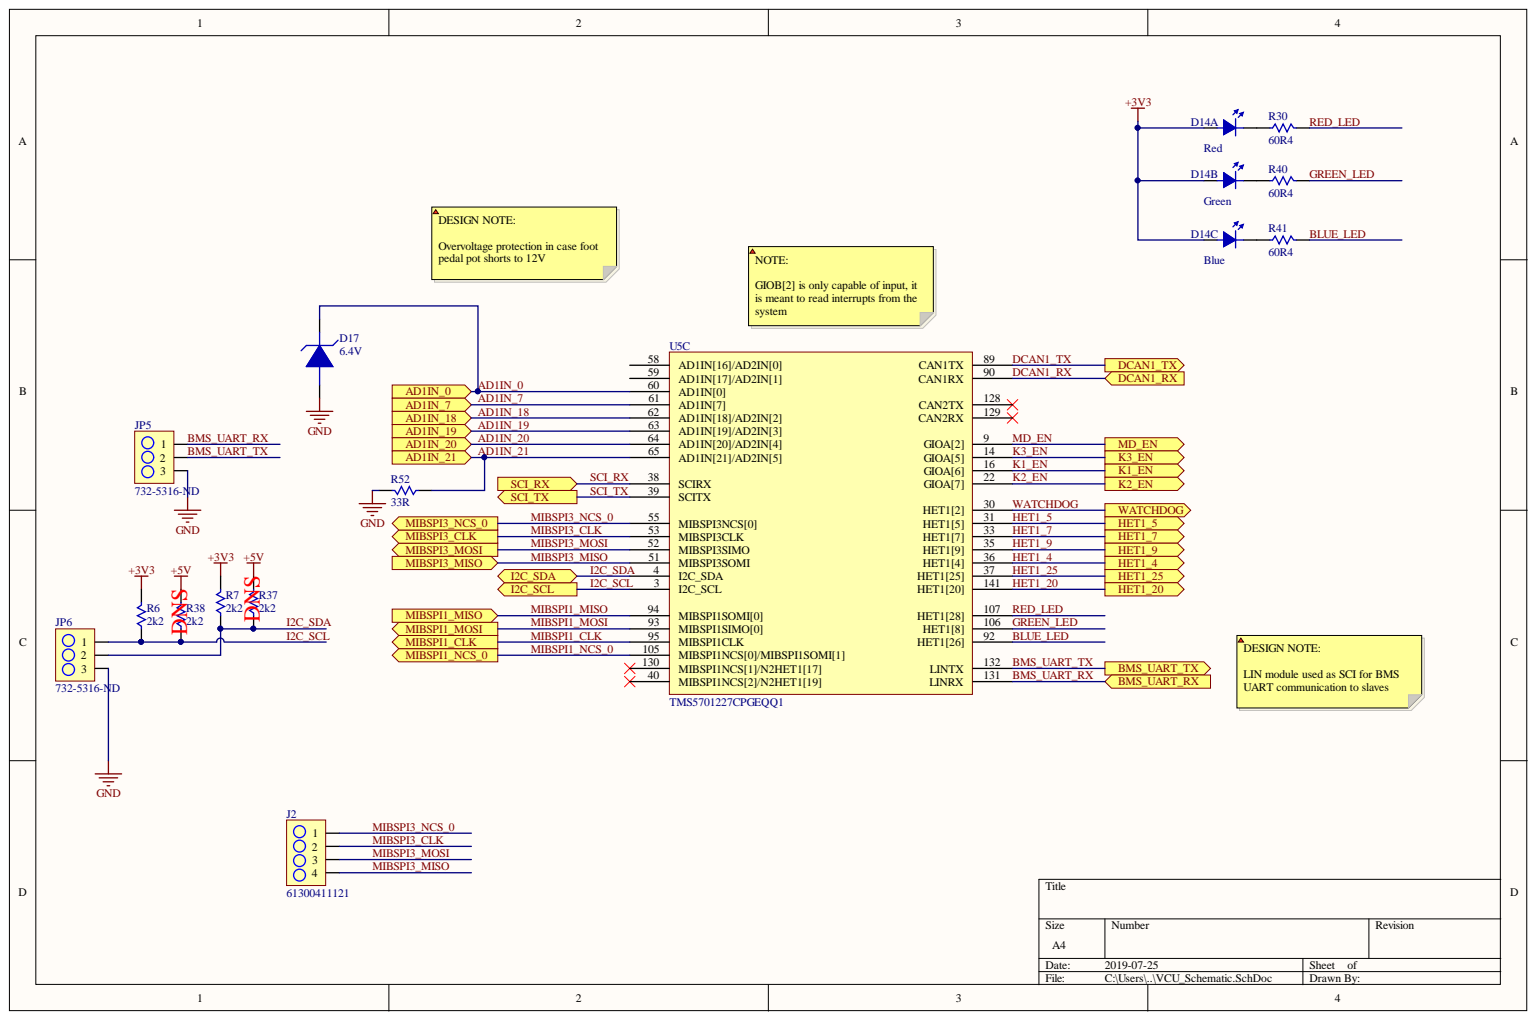
[picture p15: page 4]

Overvoltage protection in case foot

GIOB[2] is only capable of input, it
is meant to read interrupts from the
system

LIN module used as SCI for BMS
UART communication to slaves

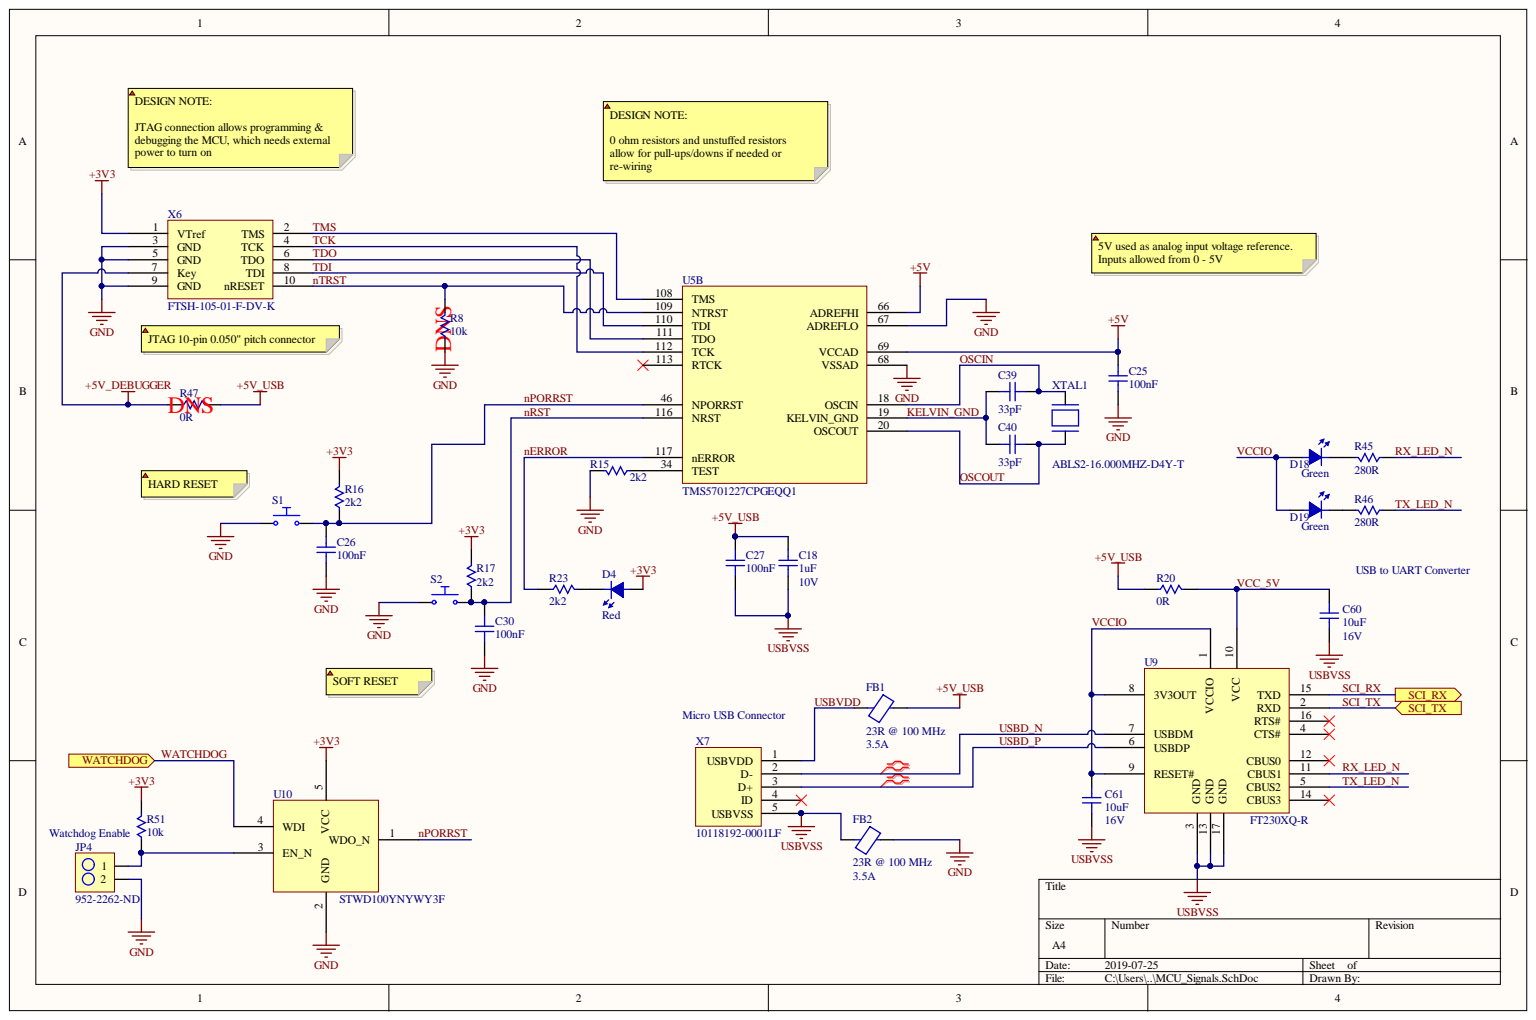
[picture p16: page 5]

JTAG connection allows programming &
debugging the MCU, which needs external
power to turn on

0 ohm resistors and unstuffed resistors
allow for pull-ups/downs if needed or
re-wiring

5V used as analog input voltage reference.
Inputs allowed from 0 - 5V

R8 10k | | TDI 110

JTAG 10-pin 0.050" pitch connector

TCK 112
RTCK 113 | OSCIN

nRST | NRST 116 | | KELVIN_GND

nERROR | | nERROR 117
R15 R23 D4 | | TEST 34

USB to UART Converter

USBDP 6 USBDM 7

USBD_P 3.5A

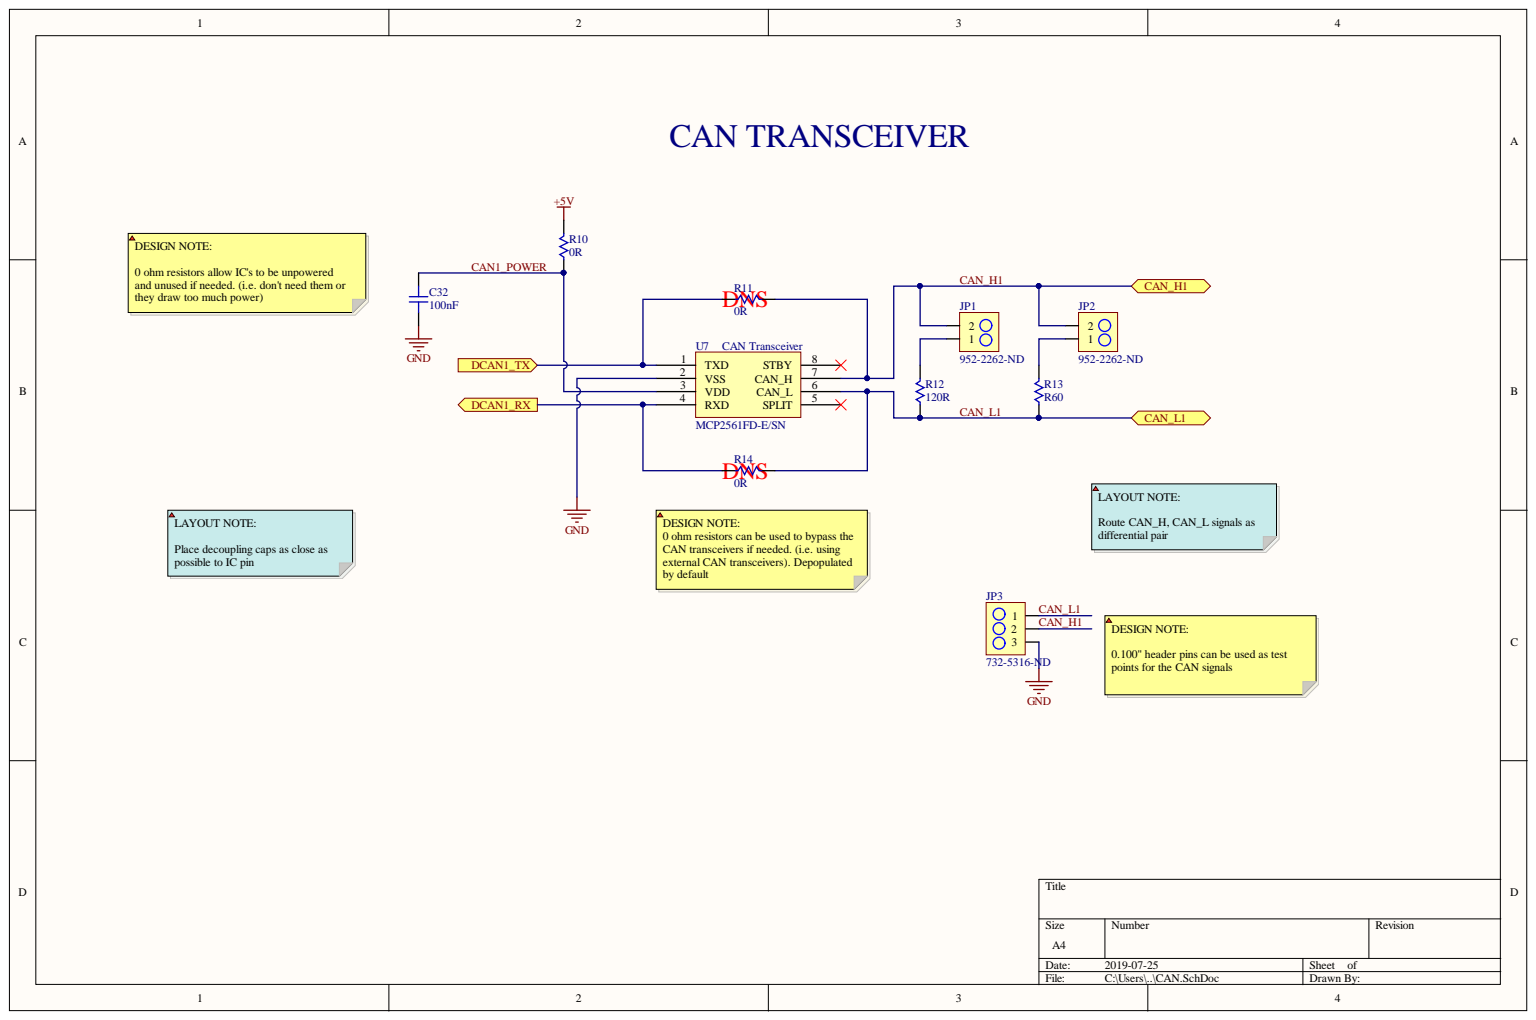
[picture p17: page 6]

0 ohm resistors allow IC's to be unpowered
and unused if needed. (i.e. don't need them or
they draw too much power)

DESIGN NOTE:
0 ohm resistors can be used to bypass the
CAN transceivers if needed. (i.e. using
external CAN transceivers). Depopulated
by default

Place decoupling caps as close as
possible to IC pin

0.100" header pins can be used as test
points for the CAN signals

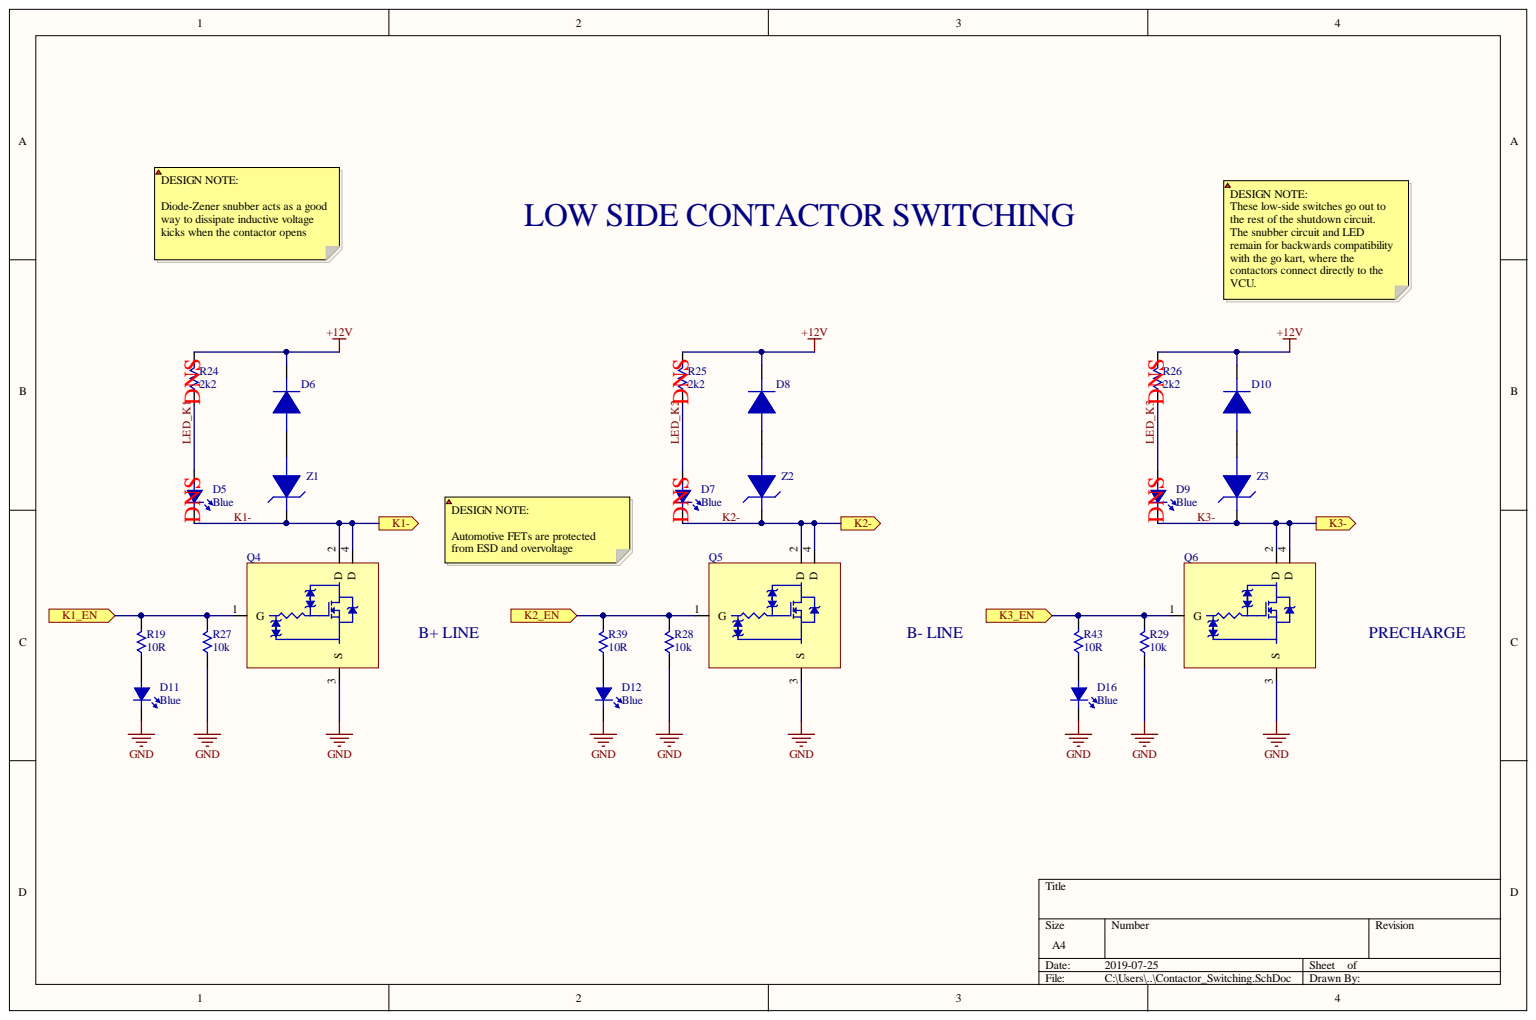
[picture p18: page 7]

DESIGN NOTE:
These low-side switches go out to
the rest of the shutdown circuit.
The snubber circuit and LED
remain for backwards compatibility
with the go kart, where the
contactors connect directly to the
VCU.

Diode-Zener snubber acts as a good
way to dissipate inductive voltage
kicks when the contactor opens

LOW SIDE CONTACTOR SWITCHING

Automotive FETs are protected
from ESD and overvoltage


Place analog input capacitors near
microcontroller pins

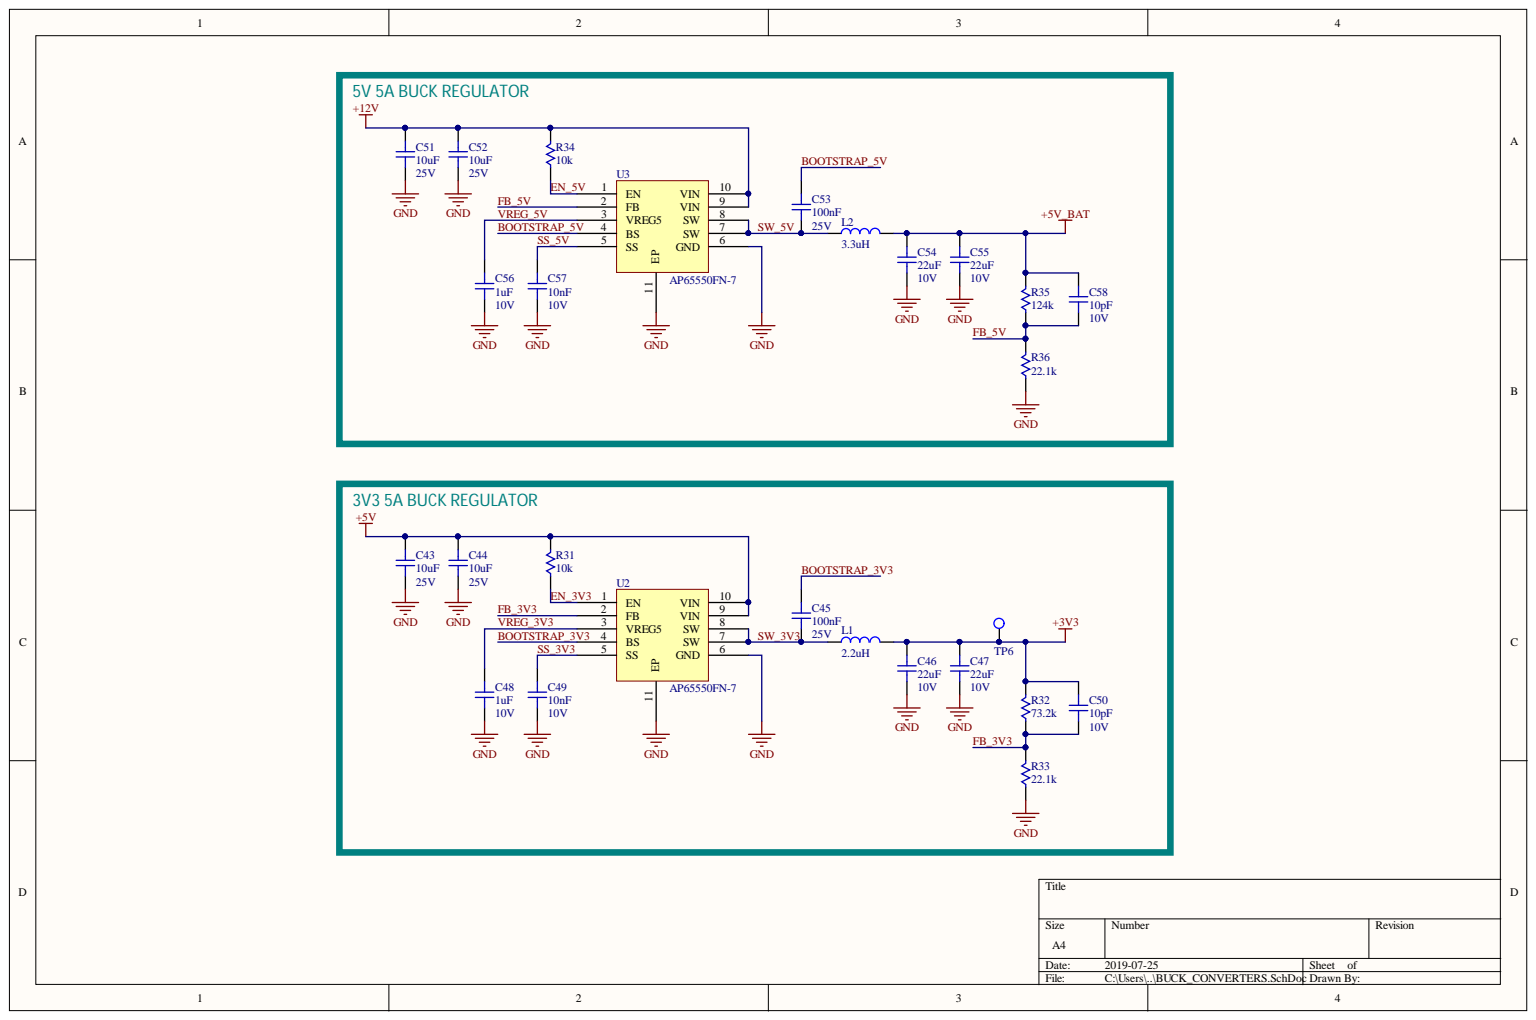
[picture p19: page 9]

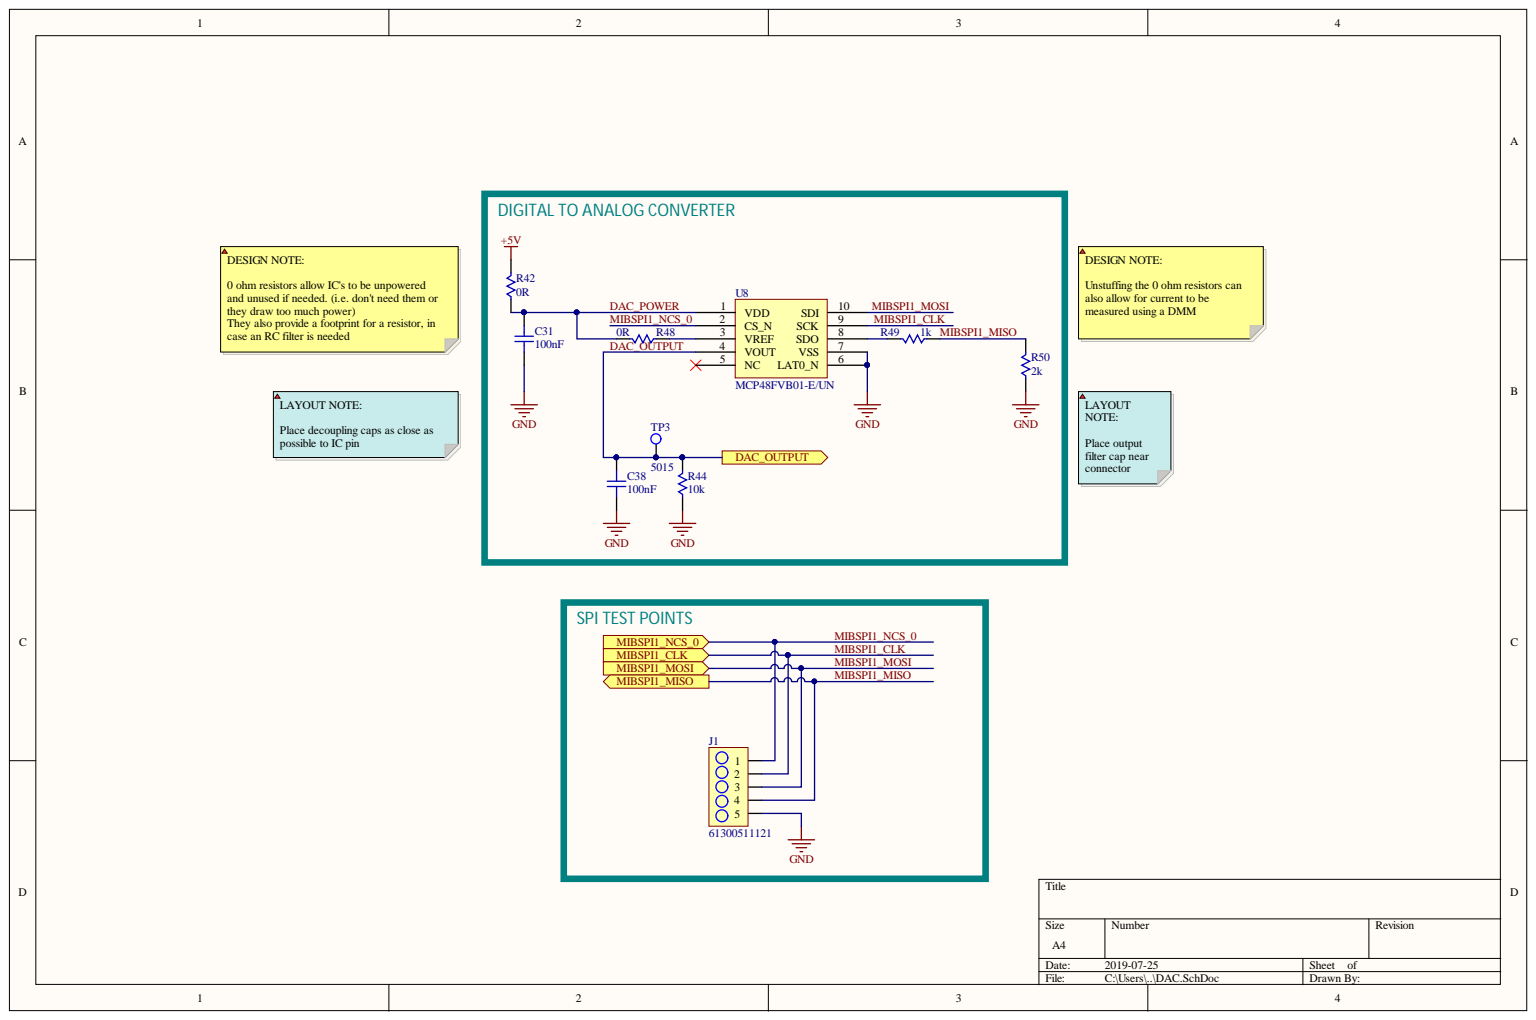
[picture p20: page 10]

DIGITAL TO ANALOG CONVERTER

0 ohm resistors allow IC's to be unpowered
and unused if needed. (i.e. don't need them or
they draw too much power)
They also provide a footprint for a resistor, in
case an RC filter is needed

Unstuffing the 0 ohm resistors can
also allow for current to be
measured using a DMM

Place decoupling caps as close as
possible to IC pin

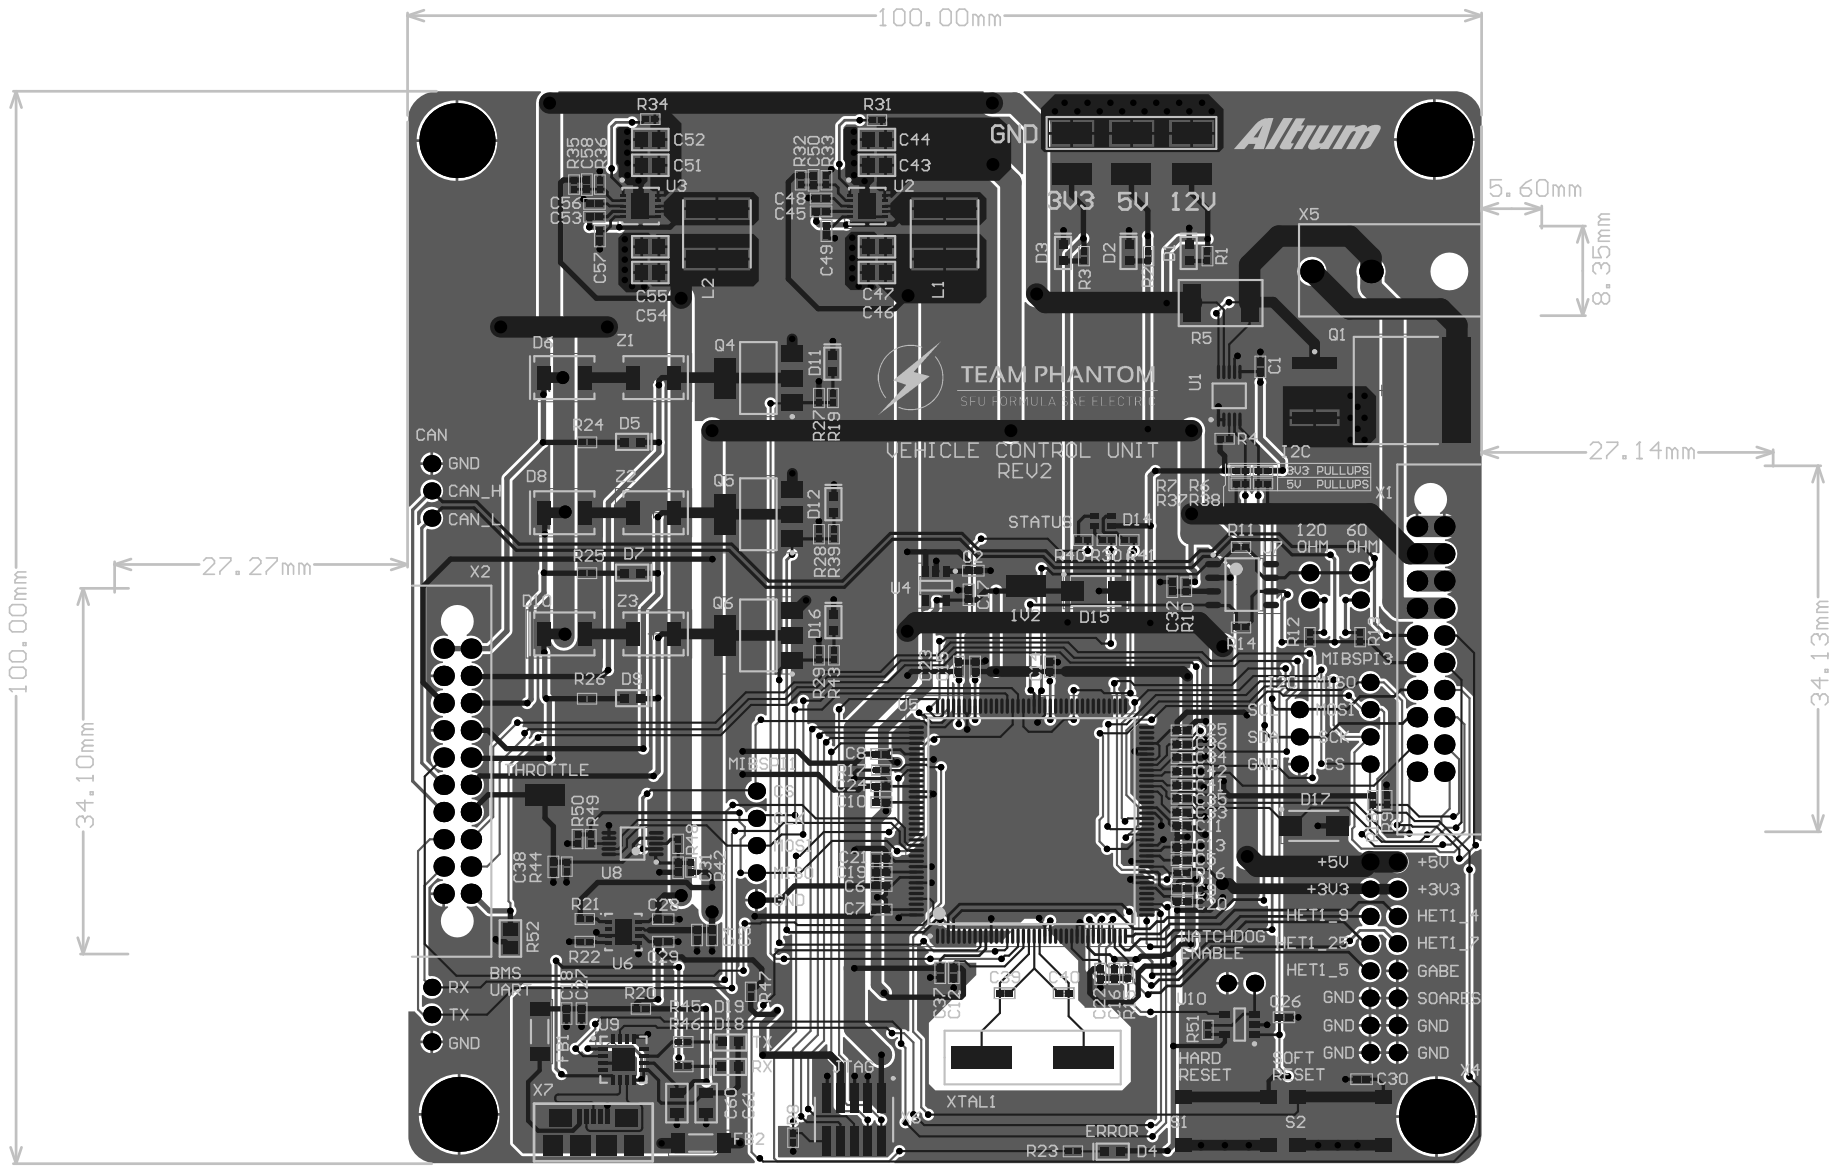
[picture p21: page 11]
