sfuphantom/vcu-hw/(list of files, drawings)

Other design files:
PHANTOM_VCU/ADC_Decoupling.SchDoc
PHANTOM_VCU/BUCK_CONVERTERS.SchDoc
PHANTOM_VCU/CAN.SchDoc
PHANTOM_VCU/Connectors.SchDoc
PHANTOM_VCU/Contactor_Switching.SchDoc
PHANTOM_VCU/DAC.SchDoc
PHANTOM_VCU/MCU_Signals.SchDoc
PHANTOM_VCU/PHANTOM_LIBRARY.SchLib
PHANTOM_VCU/PHANTOM_VCU.PrjPcb
PHANTOM_VCU/Power_MCU.SchDoc
PHANTOM_VCU/Power_Sensing.SchDoc
PHANTOM_VCU/VCU_Schematic.SchDoc
