sfuphantom/vcu-hw/(commit log)

2018-12-28 removing unnecessary history files
    [Contactor_Switching.pcbdoc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]
2018-12-28 removed gpio expander, soft reset button, extra CAN transceiver
    [CAN.SchDoc, Connectors.SchDoc, MCU_Signals.SchDoc, VCU_Schematic.SchDoc]
2018-12-28 fixed CAN backwards power error from rev0
    [CAN.SchDoc]
2018-12-28 removed 24V switched power, extra jtag resistors
    [Connectors.SchDoc, Contactor_Switching.SchDoc, MCU_Signals.SchDoc, PHANTOM_VCU.PrjPcb, VCU_Schematic.SchDoc]
2018-12-29 decreased board size to 100mmx100mm
2018-12-31 switched most caps and resistors from 0805 to 0402
    [ADC_Decoupling.SchDoc, CAN.SchDoc, Connectors.SchDoc, Contactor_Switching.SchDoc, MCU_Signals.SchDoc, Power_MCU.SchDoc, Power_Sensing.SchDoc, VCU_Schematic.SchDoc]
2019-01-01 added parts and footprints for new buck converters, also removed submodule
    [PHANTOM_LIBRARY.SchLib, PHANTOM_VCU.PrjPcb]
2019-01-01 finished schematic and layout placement of switching regulators
    [BUCK_CONVERTERS.SchDoc, PHANTOM_VCU.PrjPcb, Power_Sensing.SchDoc]
2019-01-03 added new MCU symbol and footprint
    [PHANTOM_LIBRARY.SchLib, PHANTOM_VCU.PrjPcb, TEST_BOM.xlsx]
2019-01-03 added gpio expander, wired some connections to connectors
    [BUCK_CONVERTERS.SchDoc, Connectors.SchDoc, Contactor_Switching.SchDoc, MCU_Signals.SchDoc, PHANTOM_LIBRARY.SchLib, PHANTOM_VCU.PrjPcb, Power_MCU.SchDoc, Power_Sensing.SchDoc]
2019-01-03 cost-down on LEDs, LDO, reverse polarity fet. also got rid of all old traces, starting new placement
    [Contactor_Switching.SchDoc, MCU_Signals.SchDoc, PHANTOM_LIBRARY.SchLib, Power_MCU.SchDoc, Power_Sensing.SchDoc, TEST_BOM.xlsx]
2019-01-04 changed FTDI converter, placed ORing controller, DAC
    [BUCK_CONVERTERS.SchDoc, Connectors.SchDoc, MCU_Signals.SchDoc, PHANTOM_LIBRARY.SchLib, Power_Sensing.SchDoc, VCU_Schematic.SchDoc]
2019-01-04 finished placement! time to route, let's race
    [Power_MCU.SchDoc]
2019-01-05 routed power to all components
    [Power_MCU.SchDoc]
2019-01-05 routed JTAG, SPI, UART, I2C
    [Connectors.SchDoc]
2019-01-05 routed GPIO, half of analog & pwm signals
    [Connectors.SchDoc, VCU_Schematic.SchDoc]
2019-01-05 finished all routing except for GND, need to unshelf polygon
    [Connectors.SchDoc]
2019-01-06 finished routing GND
    [BUCK_CONVERTERS.SchDoc, MCU_Signals.SchDoc]
2019-01-06 generated gerbers and drill files
    [PHANTOM_VCU.PrjPcb, TEST_BOM.xlsx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]
2019-01-11 Fixed error in gerbers
    [PHANTOM_VCU.PrjPcb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]
2019-01-23 fixed board outline mistake, added missing silkscreen, re-generated gerbers
    [VCU_LAYOUT.GBL, VCU_LAYOUT.GBO, VCU_LAYOUT.GBP, VCU_LAYOUT.GBS, VCU_LAYOUT.GM1, VCU_LAYOUT.GTL, VCU_LAYOUT.GTO, VCU_LAYOUT.GTP]
2019-02-16 fixed 3V3 connection, 12V silk, bottom side silk lining up, USB to UART footprint pads lengthened, schematic pdf and gerbers generated
    [PHANTOM_VCU.PrjPcb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]
2019-02-20 changed 3V3 buck input from 12V to 5V, to accommodate USB-only power
    [BUCK_CONVERTERS.SchDoc, PHANTOM_VCU.PrjPcb]
2019-05-02 cleaning up schematic
    [Connectors.SchDoc, MCU_Signals.SchDoc, Power_MCU.SchDoc, Power_Sensing.SchDoc]
2019-05-21 updated nRESET to nTRST for JTAG
    [MCU_Signals.SchDoc]
2019-05-21 created DAC schematic sheet, removed GPIO expander in favour of pinmux on the HET ports
    [DAC.SchDoc, MCU_Signals.SchDoc, PHANTOM_VCU.PrjPcb, VCU_Schematic.SchDoc]
2019-05-21 fixed FTDI footprint, added tricolour LED status, removed redundant SPI signals
    [Connectors.SchDoc, MCU_Signals.SchDoc, PHANTOM_LIBRARY.SchLib, VCU_Schematic.SchDoc]
2019-05-22 small changes, fixed compilation errors, fixed missing footprints, lots to change in the layout still
    [CAN.SchDoc, Connectors.SchDoc, DAC.SchDoc, MCU_Signals.SchDoc, PHANTOM_LIBRARY.SchLib, Power_MCU.SchDoc, Power_Sensing.SchDoc, VCU_Schematic.SchDoc]
2019-05-25 routed mibspi3 for thermistor expansion
    [BUCK_CONVERTERS.SchDoc, CAN.SchDoc, Connectors.SchDoc, MCU_Signals.SchDoc, PHANTOM_LIBRARY.SchLib, PHANTOM_VCU.PrjPcb, Power_MCU.SchDoc, VCU_Schematic.SchDoc]
2019-05-25 routed extra HET/GPIO pins to connector
    [Connectors.SchDoc, PHANTOM_LIBRARY.SchLib, VCU_Schematic.SchDoc]
2019-05-30 Added extra debug headers for SPI, routed shutdown circuit GPIO for BMS, ran design rule check to fix all unrouted nets
    [Connectors.SchDoc, MCU_Signals.SchDoc, PHANTOM_LIBRARY.SchLib, Power_MCU.SchDoc, VCU_Schematic.SchDoc]
2019-05-31 added TX/RX LEDs for PC UART
    [MCU_Signals.SchDoc]
2019-05-31 added 5V option to power from Segger debugger, will need our custom adapter
    [MCU_Signals.SchDoc]
2019-06-02 added and routed new DAC
    [DAC.SchDoc, MCU_Signals.SchDoc, PHANTOM_LIBRARY.SchLib, VCU_Schematic.SchDoc]
2019-06-03 fixed I2C address and switched to 3V3 power
    [Power_Sensing.SchDoc, VCU_Schematic.SchDoc]
2019-06-07 Added better silk on bottom overlay for pins, fixed some routing and created a board outline layer
    [Connectors.SchDoc, Contactor_Switching.SchDoc, Power_Sensing.SchDoc]
2019-06-08 Added external automotive-rated watchdog timer IC, times out after 1.6s of no petting
    [CAN.SchDoc, Connectors.SchDoc, DAC.SchDoc, MCU_Signals.SchDoc, PHANTOM_LIBRARY.SchLib, PHANTOM_VCU.PrjPcb, Power_MCU.SchDoc, Power_Sensing.SchDoc]
2019-06-18 Added logo, fixed some alignments and changes from initial review. still need to match USB diff pair lengths and add sense resistor
    [Connectors.SchDoc, DAC.SchDoc, MCU_Signals.SchDoc]
2019-06-22 Fixed some silk, added sense resistor, matched usb trace lengths, generated gerbers
    [PHANTOM_LIBRARY.SchLib, PHANTOM_VCU.PrjPcb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]
2019-09-23 Updated schematic PDF
    [PHANTOM_VCU.PrjPcb, VCU_BOM_IncludingInventory.xlsx, VCU_BOM_noSupplier.xlsx, VCU_LAYOUT_BOM.xlsx]
2019-12-30 Moved right connector to the left side, half started re-routing all signals, working in parallel with harnessing to optimize connector outputs
    [Connectors.SchDoc]
2020-01-20 modifying BMS UART routing, changing wake/fault pins to GIO port A
2020-06-27 Fixed some routing, connectors should still be reviewed and some more things to route
    [Connectors.SchDoc]
2020-06-27 changed LDO 300mA to 600mA
    [PHANTOM_VCU.PrjPcb, Power_MCU.SchDoc]
2020-09-04 Added MOSFET buffers to RGB LEDs
    [PHANTOM_LIBRARY.SchLib, PHANTOM_VCU.PrjPcb, VCU_Schematic.SchDoc]
2020-09-19 Removed contactor LEDs, swapped UART TX/RX silk
    [Contactor_Switching.SchDoc, VCU_Schematic.SchDoc]
2020-09-19 Added USB and JTAG esd diodes to schematic
    [MCU_Signals.SchDoc]
2020-09-19 routed esd diode to footprint
    [MCU_Signals.SchDoc]
2020-09-19 routed esd usb to footprint
    [MCU_Signals.SchDoc]
2020-10-02 Finished routing top connector
    [Connectors.SchDoc, PHANTOM_LIBRARY.SchLib, VCU_Schematic.SchDoc]
2020-10-04 Updated CAN transceiver from MCP2561 to MCP2562T
    [CAN.SchDoc, PHANTOM_VCU.PrjPcb]
2020-10-04 routed updated CAN transceiver to pcb
2020-10-08 Finished routing bottom connector
    [Connectors.SchDoc]
2020-10-09 routed new MCP2562T CAN transceiver to pcb
    [CAN.SchDoc]
2020-10-11 Included Rafael's CAN changes, fixed a net antenna
    [CAN.SchDoc, PHANTOM_VCU.PrjPcb]
2020-10-13 updated PDF of PCB
